23vsgroi/Battery-Charger/Battery Charger Project/Demo/README.txt

This project is an off-grid wind powered CC/CV charger for 8AH, 12V and 24V LFP battery packs.

General architecture

Wind turbine -> Generator -> Three phase rectifier -> buck converter -> battery pack
