23vsgroi/Battery-Charger/Battery Charger Project/Demo/Schematics/README.txt

For the first prototype, I will be using a gate drive evaluation board and a PCB that I am making.

The buck converter MOSFET and diode will be on the evaluation board, which can be seen on the high level schematic.
