23vsgroi/Battery-Charger/Battery Charger Project/Demo/Graphs/Charging (24V pack)/README.txt

Charging graph 1:

	On the top graph:

		Green: Battery pack terminal voltage

		Red: Battery pack VOC

	On the bottom graph:
		
		Green: Difference between pack VOC and pack terminal voltage
		Red: Battery SOC

Charging graph 2:
	
	Blue: Cell terminal voltage

	Red: Cell VOC

	Green: SOC
