23vsgroi/Battery-Charger/Battery Charger Project/Demo/Graphs/Discharging (Cell)/README.txt

Discharge graph:

	Blue: Cell VOC

	Green: Cell terminal voltage

	Red: Cell SOC
