23vsgroi/Battery-Charger/Battery Charger Project/Docs/Off-Grid Battery Charger.pptx

## Off-Grid Battery Charger

Zano Sgroi
*Currently in development: May 2026 - Present

## Project description

- 220W wind powered CC/CV charger for 12V and 24V, 8Ah LFP battery packs
- Charging rates of 1C (8A) and 0.25C (2A) based on generator frequency
- Initial prototype utilizes a gate driver evaluation board
- TI F28379D LaunchPad used for feedback control and system I/O

## High level schematic

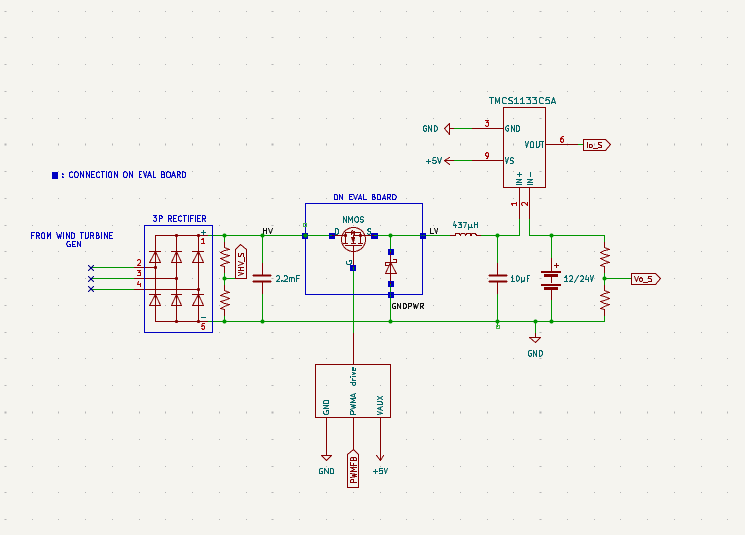
[picture p1: figure]

## PCB schematic

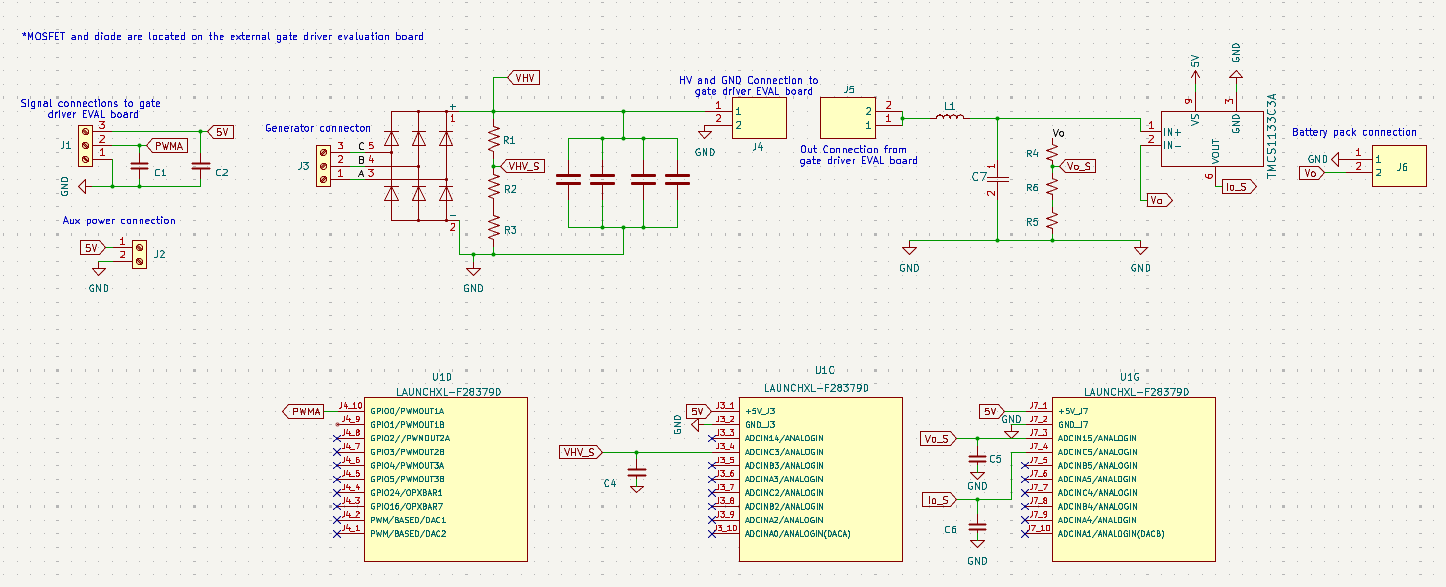
[picture p2: figure]

## PCB layout

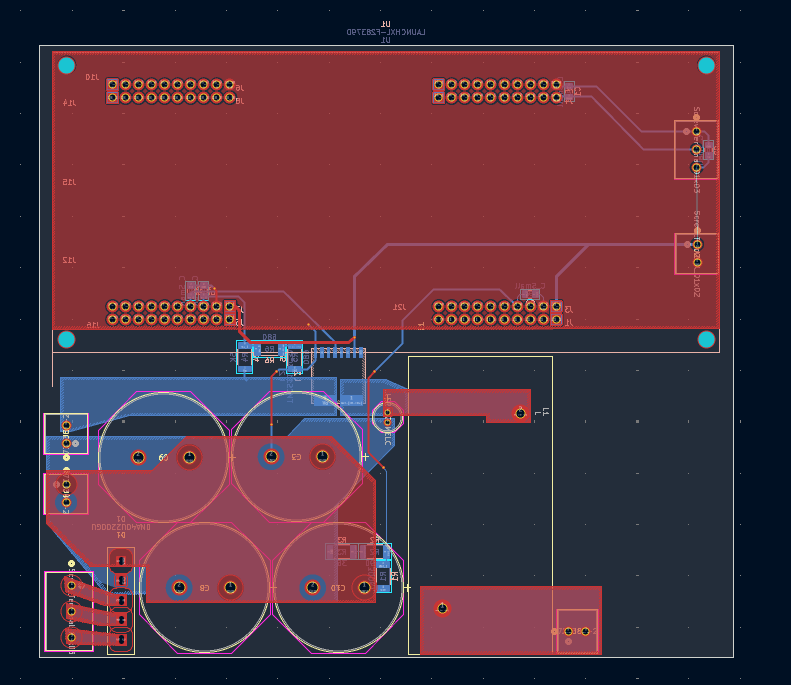
[picture p3: figure]

## Generator output data

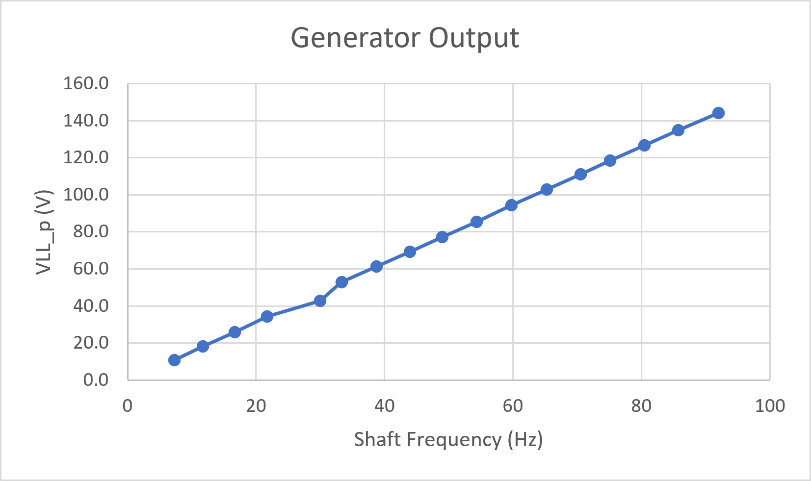
[picture p4: figure]

## PLECS system simulation

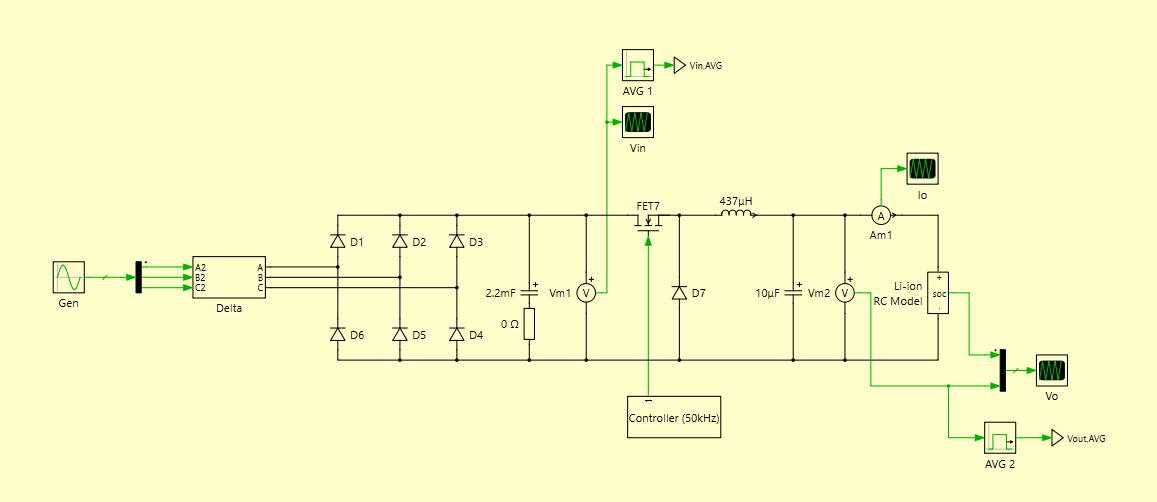
[picture p5: figure]

## Random operating point simulation

- 24V battery pack at 63% SOC
- 8A charging current
- Generator L-L peak output of 112V at 71 Hz

## Rectifier output voltage (Vm1)

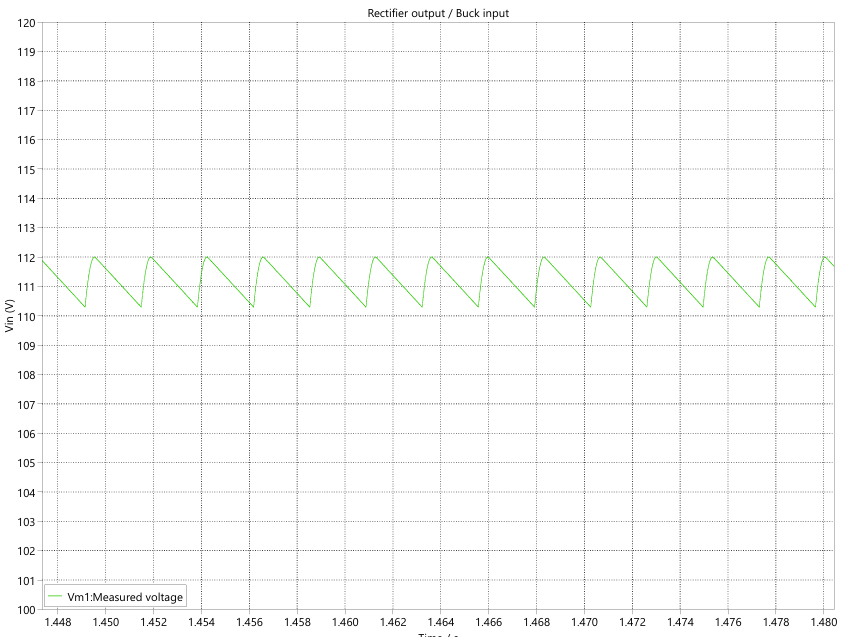
[picture p6: figure]

## Battery Voltage (Vm2)

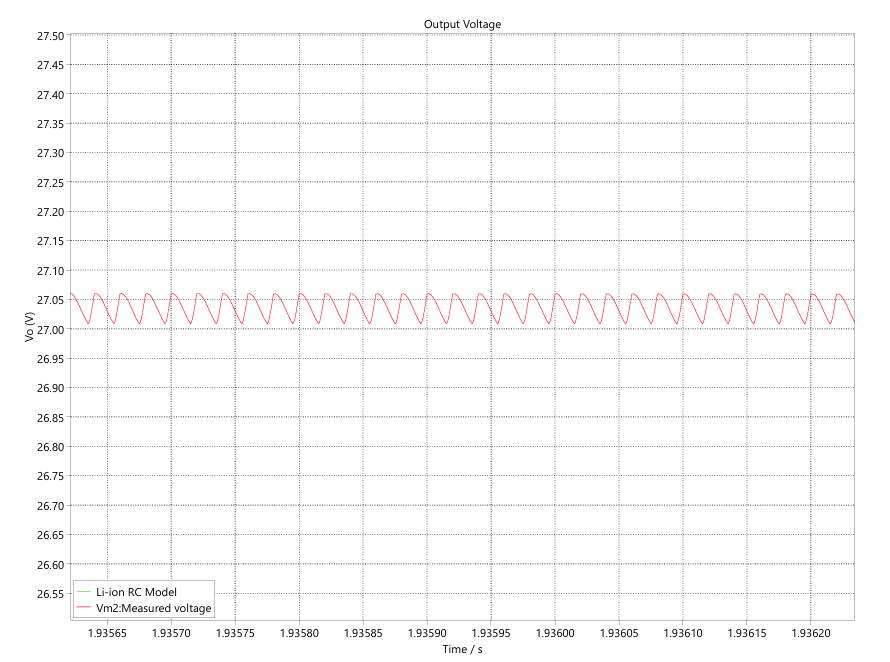
[picture p7: figure]

## Battery Current (Am1)

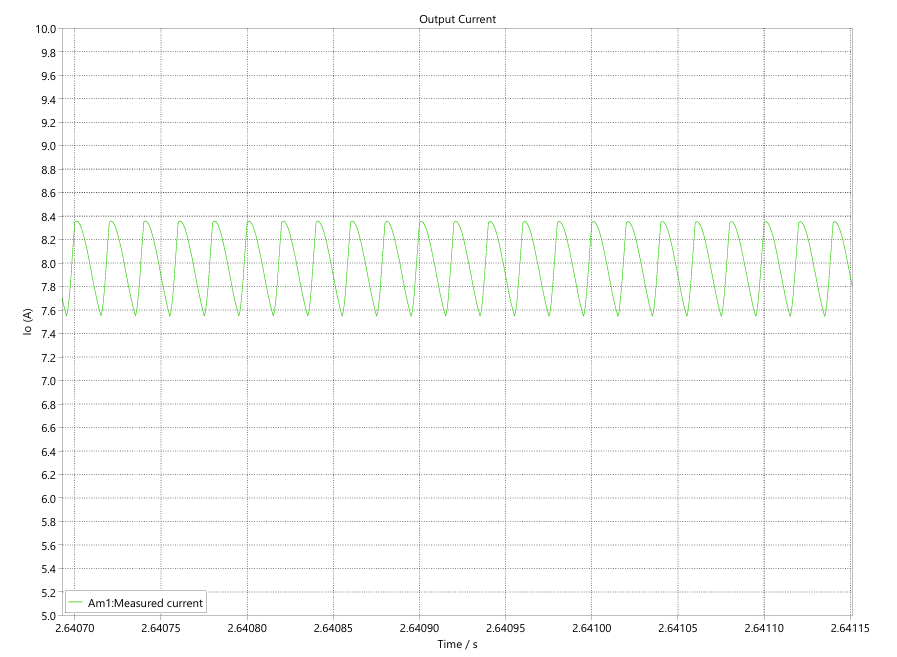
[picture p8: figure]

## LFP battery model

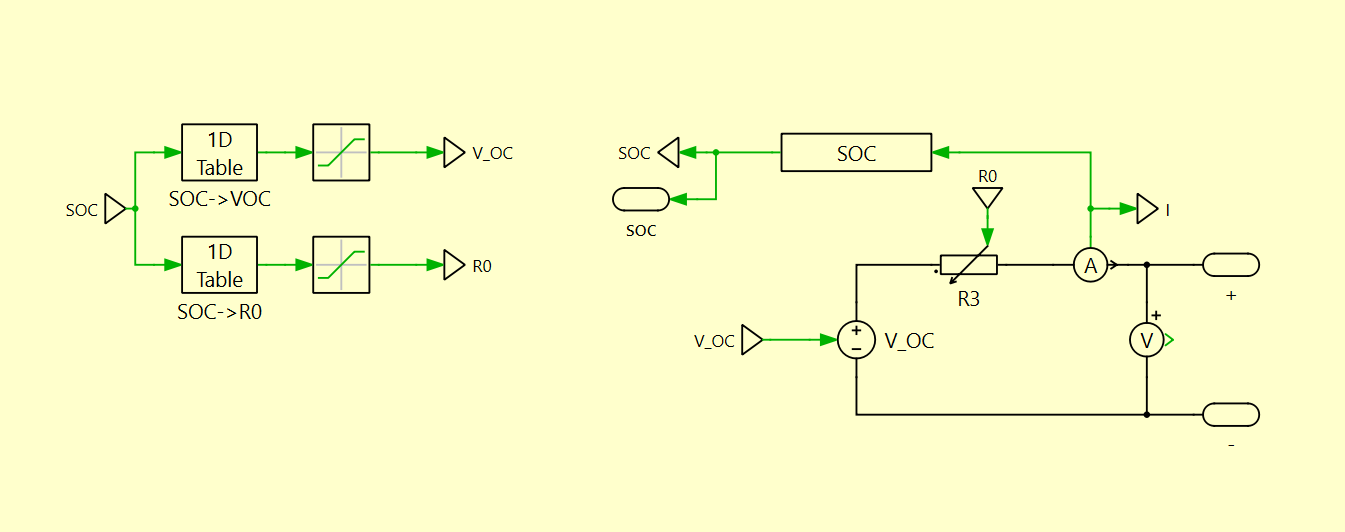
[picture p9: figure]
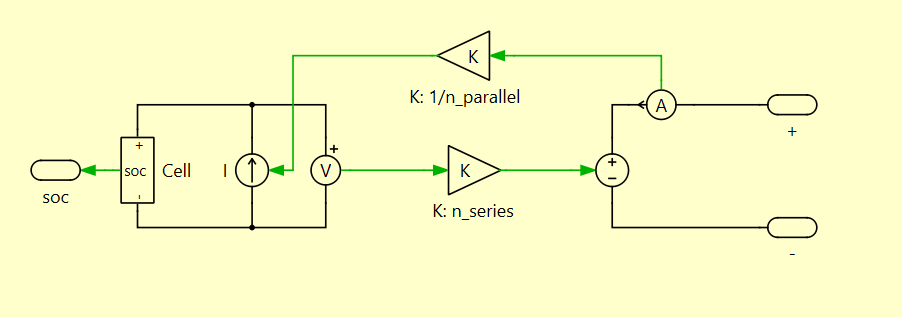
[picture p10: figure]

## Battery pack model charging simulation

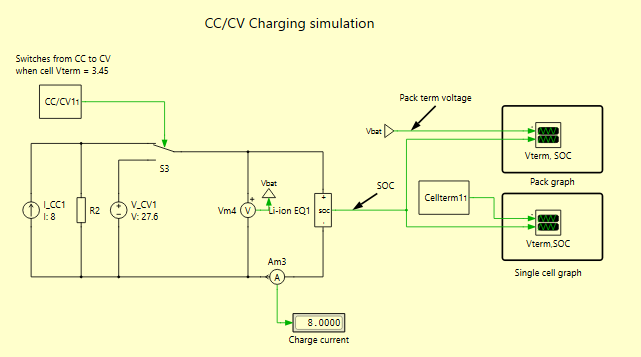
[picture p11: figure]

## Battery pack model charging graph

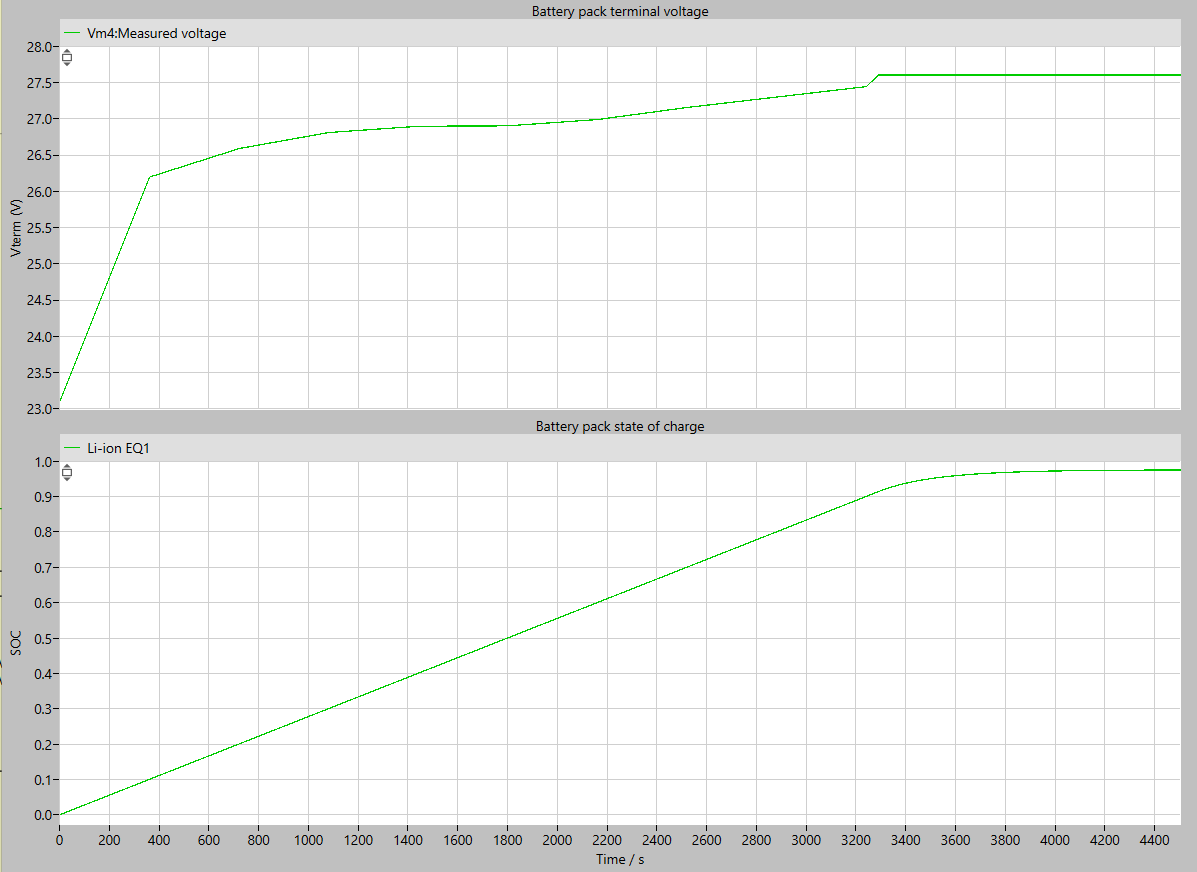
[picture p12: figure]

## Battery cell model charging graph

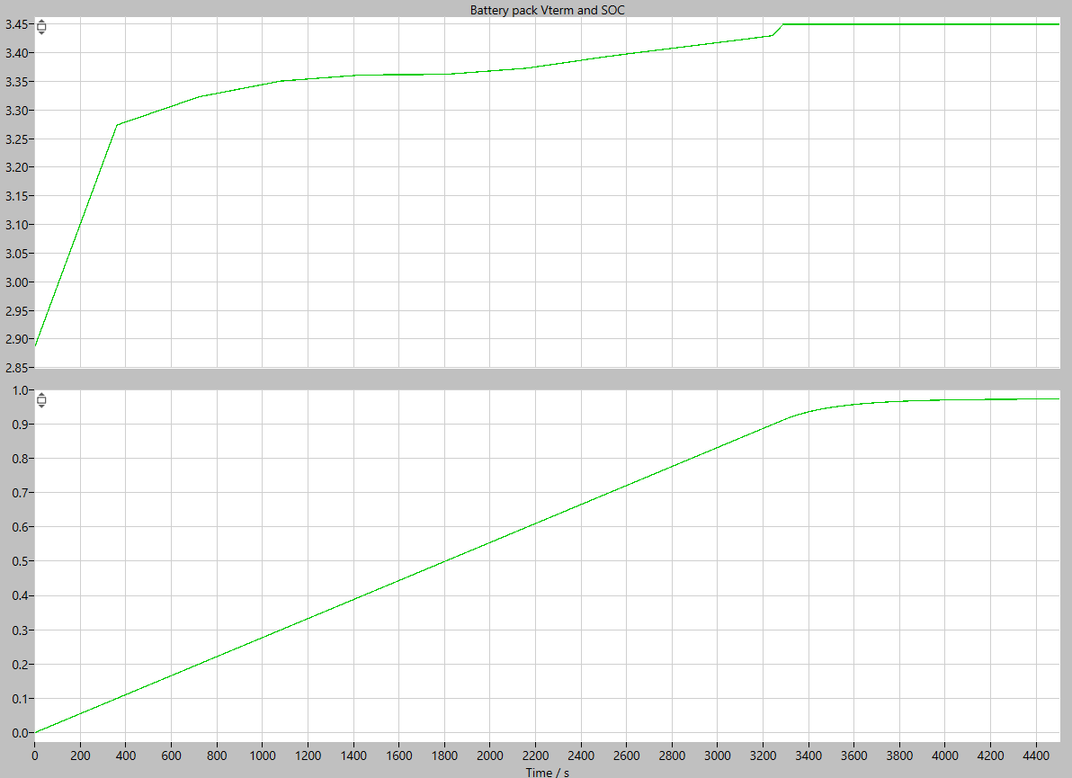
[picture p13: figure]

## Rectifier capacitor and gen freq. graphs

- MATLAB graphs show the worst-case rectifier capacitance for each VLL to keep voltage ripple below 5%
- Increasing charging currents are graphed: 1A, 2A, 4A, 8A and 12A
- 22mF point is shown on the 2A and 8A graphs
- Capacitance requirement is the same at these points due to charging current difference

## 24V pack

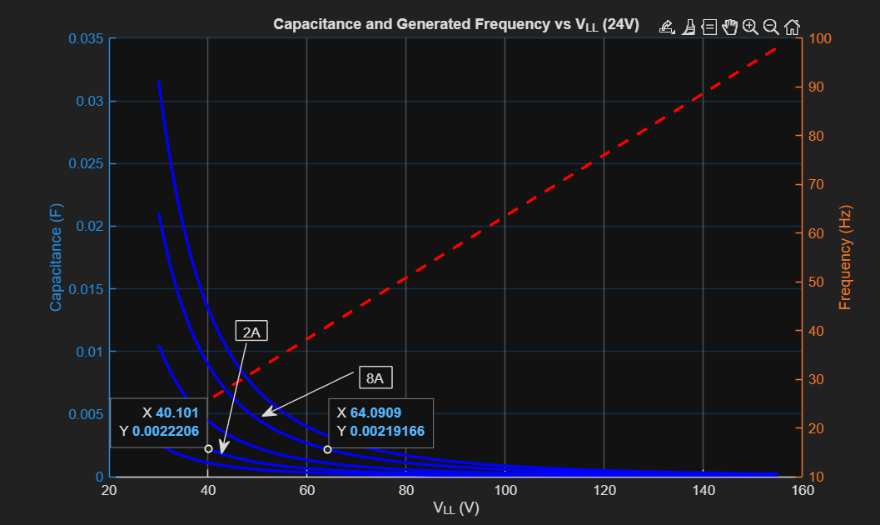
[picture p14: figure]

## 12V pack

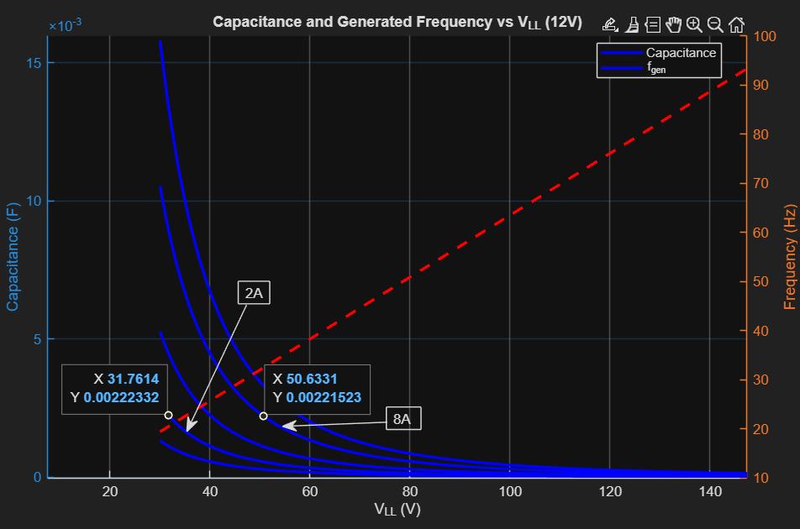
[picture p15: figure]

## Bill of materials

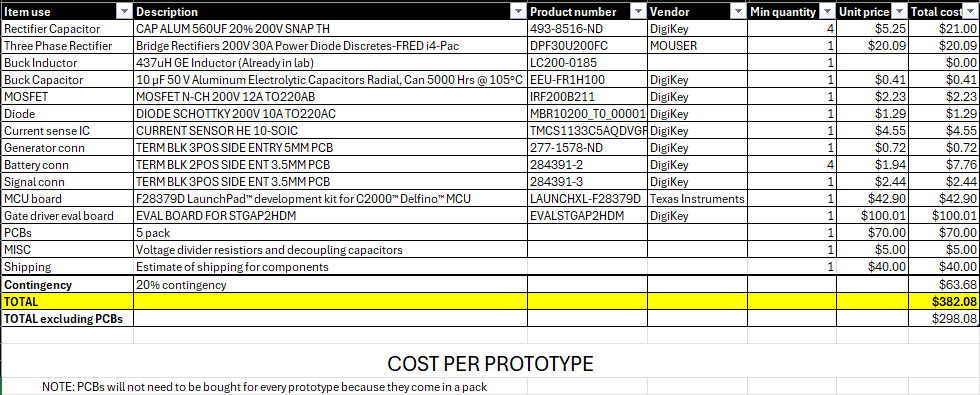
[picture p16: figure]
