23vsgroi/Battery-Charger/Battery Charger Project/Docs/Logs/BC project questions.docx

# Battery Charger Project Questions

5/12/2026

- If a buck converters input voltage changes, does the output voltage remain the same?
- ~~Does the EVALSTGAP2HD buck converter have control logic to maintain steady output voltage~~
- How does a gate driver work and what is the purpose of each terminal on the IC?
- What is the generator output voltage range
- How are CC and CV modes implemented on Buck converter?
- Will I be making the rectifiers and buck converters or using premade components?

5/13/2026

- Why can the PWM block in the feedback loop just be d=(Vref)/(Vs) to get the duty ratio?
- How would the Vc be comparison with sawtooth be implemented?
- Can the Vref in the CV feedback be used to create CC?
- How can voltage across a shunt be used in the feedback circuit to maintain constant current?
- Does resistance across a Lithium phosphate battery change as it charges
- How does battery charging work? Is it not two voltages sources in parallel?

5/21/2026

- How does a difference amplifier work?
- Will the charger use a MCU to switch from CC to CV or hardware
- How can I get 12V and 24V on my ref pin?
- When in CV mode, do you have to force current to trickle off or does it occur naturally?
- When should the MCU be used and not used?
- Will the PWM block implementation be a IC?

5/26/2026

- Is the transistor on the evaluation board the one in the actual buck converter circuit?
- How does high side gate driving work?
- What is dc to dc isolation on evaluation board?
- How does a current sensing IC work and how is the IC used?

5/28/2026

- What are open drain outputs?
- Why does the TMCS1133 IC have two VS pins?
- What is the IO voltage range on the control card?

6/2/2026

- When charging a battery pack, do you look at measure a single cell voltage or the pack voltage?
- Does the generator data sheet have the voltage in RMS, L-L, etc.?
- How many cells will be in the LFP battery pack for 12 and 24V?
- What should the minimum input to the buck converter be?
