23vsgroi/Battery-Charger/Battery Charger Project/MATLAB/Plots/V2/Charging Currents.png

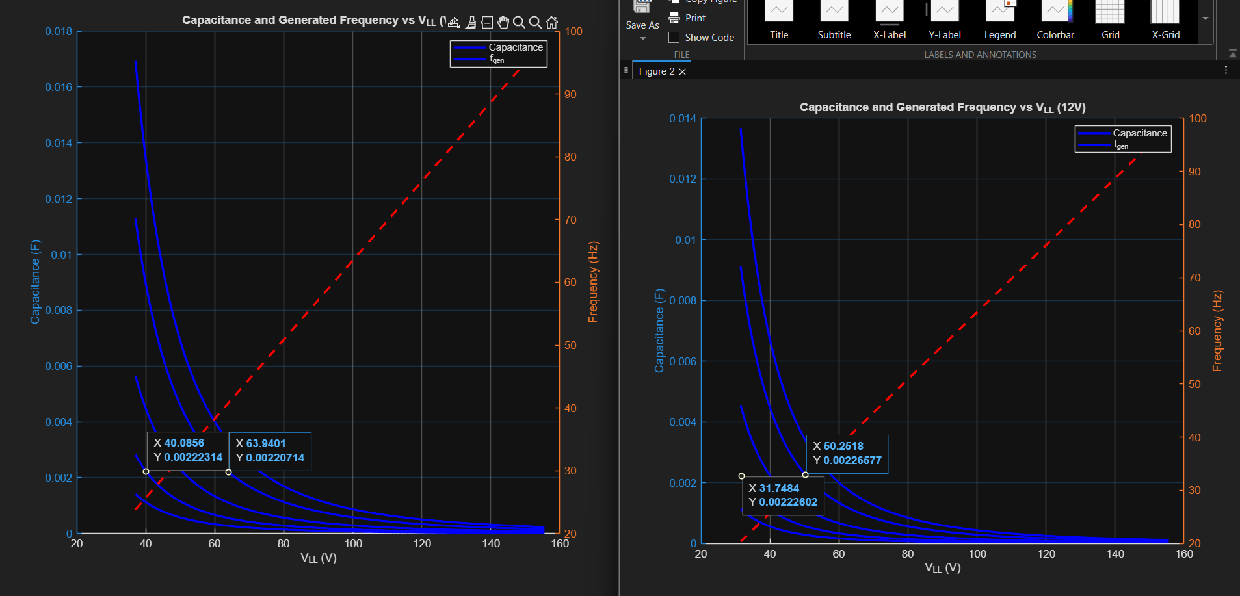
Battery Charger Project/MATLAB/Plots/V2/Charging Currents.png
