23vsgroi/Battery-Charger/Battery Charger Project/MATLAB/Plots/V2/Screenshot 2026-08-26 115330.png

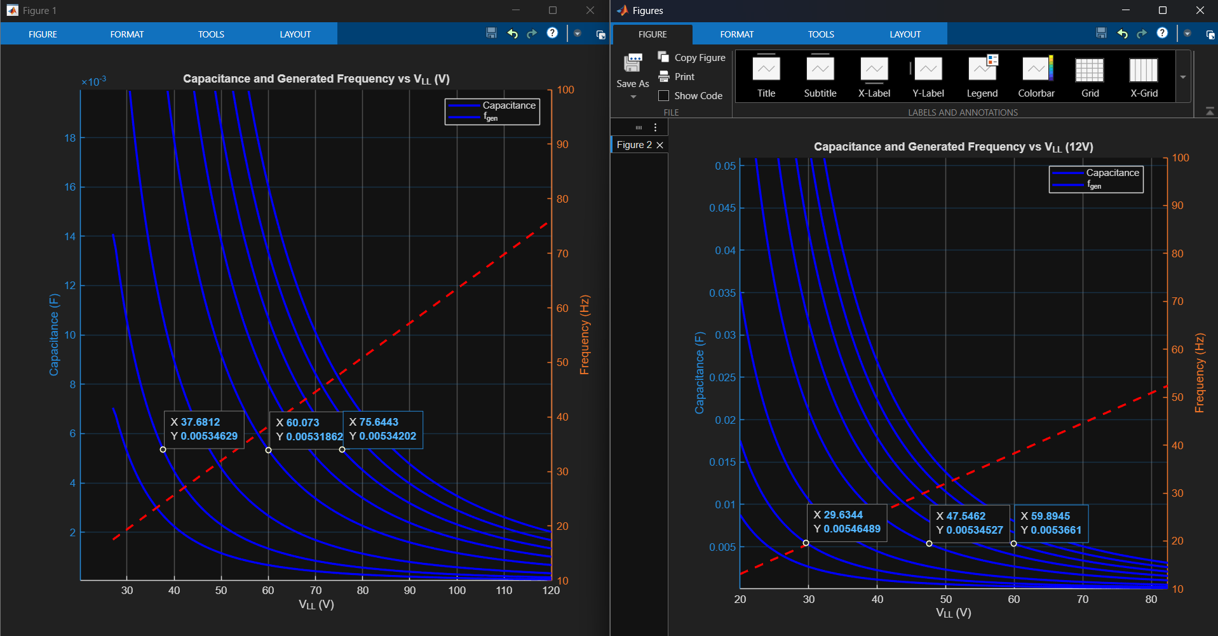
Battery Charger Project/MATLAB/Plots/V2/Screenshot 2026-08-26 115330.png
