23vsgroi/Battery-Charger/Battery Charger Project/Excel/BOM/BOM V2 UNIT.xlsx

Sheet: Minimum
Item use | Description | Product number | Vendor | Link | Min quantity | Unit price | Total cost
Rectifier Capacitor | CAP ALUM 560UF 20% 200V SNAP TH | 493-8516-ND | DigiKey | https://www.digikey.com/en/products/detail/nichicon/LGW2D561MELA30/1966872 | 4 | $5.25 | $21.00
Three Phase Rectifier | Bridge Rectifiers 200V 30A Power Diode Discretes-FRED i4-Pac | DPF30U200FC | MOUSER | https://www.mouser.com/en/ProductDetail/IXYS/DPF30U200FC?qs=rQFj71Wb1eWHztVyBgjseQ%3D%3D | 1 | $20.09 | $20.09
Buck Inductor | 437uH GE Inductor (Already in lab) | LC200-0185 |  |  | 1 |  | $0.00
Buck Capacitor | 10 µF 50 V Aluminum Electrolytic Capacitors Radial, Can 5000 Hrs @ 105°C | EEU-FR1H100 | DigiKey | https://www.digikey.com/en/products/detail/panasonic-industry/EEU-FR1H100/9921028 | 1 | $0.41 | $0.41
MOSFET | MOSFET N-CH 200V 12A TO220AB | IRF200B211-ND | DigiKey | IRF200B211 Infineon Technologies | Single FETs, MOSFETs | DigiKey (https://www.digikey.com/en/products/detail/infineon-technologies/IRF200B211/5250541) | 1 | $2.23 | $2.23
Diode | DIODE SCHOTTKY 200V 10A TO220AC | MBR10200_T0_00001 | DigiKey | https://www.digikey.com/en/products/detail/panjit-international-inc/MBR10200-T0-00001/15799461 | 1 | $1.29 | $1.29
Current sense IC | CURRENT SENSOR HE 10-SOIC | TMCS1133C5AQDVGR | DigiKey | https://www.digikey.com/en/products/detail/texas-instruments/TMCS1133C5AQDVGR/23331381 | 1 | $4.55 | $4.55
Generator conn | TERM BLK 3POS SIDE ENTRY 5MM PCB | 277-1578-ND | MOUSER | https://www.mouser.com/en/ProductDetail/Phoenix-Contact/1935174?qs=QWULklcAmSR8B7o4YouITA%3D%3D | 1 | $0.72 | $0.72
Battery conn | TERM BLK 2POS SIDE ENT 3.5MM PCB | 284391-2 | DigiKey | https://www.digikey.com/en/products/detail/te-connectivity-amp-connectors/284391-2/1827021 | 4 | $1.94 | $7.76
Signal conn | TERM BLK 3POS SIDE ENT 3.5MM PCB | 284391-3 | DigiKey | https://www.digikey.com/en/products/detail/te-connectivity-amp-connectors/284391-3/1827022 | 1 | $2.44 | $2.44
HV divider resistor | RES 5.1K OHM 1% 3/4W 2010 | RC2010FK-075K1L | DigiKey | https://www.digikey.com/en/products/detail/yageo/RC2010FK-075K1L/5921466 | 1 | $0.23 | $0.23
HV divider resistor | RES 820 OHM 1% 3/4W 2010 | RC2010FK-13820RL | DigiKey | https://www.digikey.com/en/products/detail/yageo/RC2010FK-13820RL/17016426 | 1 | $0.23 | $0.23
HV divider resistor | RES 3502 300K 1% | 3502300KFT | DigiKey | https://www.digikey.com/en/products/detail/te-connectivity-passive-product/3502300KFT/9926680 | 1 | $0.95 | $0.95
Vo divider resistor | RES 5.6K OHM 1% 1.25W 2010 | CRGP2010F5K6 | DigiKey | https://www.digikey.com/en/products/detail/te-connectivity-passive-product/CRGP2010F5K6/8577271 | 1 | $0.45 | $0.45
Vo divider resistor | RES SMD 620 OHM 1% 1W 2010 | CRCW2010620RFKEFHP | DigiKey | https://www.digikey.com/en/products/detail/vishay-dale/CRCW2010620RFKEFHP/2222172 | 1 | $0.56 | $0.56
Vo divider resistor | RES 51K OHM 1% 3/4W 2010 | RC2010FK-0751KL | DigiKey | https://www.digikey.com/en/products/detail/yageo/RC2010FK-0751KL/5921434 | 1 | $0.23 | $0.23
Decap 0.1UF | CAP CER 0.1UF 50V X7R 0805 | CC0805KRX7R9BB104 | DigiKey | https://www.digikey.com/en/products/detail/yageo/CC0805KRX7R9BB104/302874 | 1 | $0.18 | $0.18
Decap 1UF | CAP CER 1UF 50V X7R 0805 | CC0805JKX7R9BB105 | DigiKey | CC0805JKX7R9BB105 YAGEO | Ceramic Capacitors | DigiKey (https://www.digikey.com/en/products/detail/yageo/CC0805JKX7R9BB105/7164382) | 1 | $0.38 | $0.38
Decap 10UF | CAP CER 10UF 16V X5R 0805 | CC0805KRX5R7BB106 | DigiKey | https://www.digikey.com/en/products/detail/yageo/CC0805KRX5R7BB106/7164386 | 1 | $0.63 | $0.63
MCU header pins | CONN HEADER VERT 20POS 2.54MM | TSW-110-07-F-D | DigiKey | https://www.digikey.com/en/products/detail/samtec-inc/TSW-110-07-F-D/2685964 | 4 | $1.06 | $4.24
MCU board | F28379D LaunchPad™ development kit for C2000™ Delfino™ MCU | LAUNCHXL-F28379D | Texas Instruments | https://www.ti.com/tool/LAUNCHXL-F28379D (https://www.ti.com/tool/LAUNCHXL-F28379D?keyMatch=LAUNCHXL-F28379D&tisearch=universal_search&usecase=hardware) | 1 | $42.90 | $42.90
Gate driver eval board | EVAL BOARD FOR STGAP2HDM | EVALSTGAP2HDM | DigiKey | https://www.digikey.com/en/products/detail/stmicroelectronics/EVALSTGAP2HDM/ | 1 | $100.01 | $100.01
PCBs | 5 pack |  |  |  | 1 | $70.00 | $70.00
Shipping | Estimate of shipping for components |  |  |  | 1 | $40.00 | $40.00
Contingency | 20% contingency |  |  |  |  |  | $64.30
TOTAL |  |  |  |  |  |  | $385.78
TOTAL excluding PCBs |  |  |  |  |  |  | $301.78
COST PER PROTOTYPE
NOTE: PCBs will not need to be bought for every prototype because they come in a pack

Sheet: Suggested
item use | Item description | product number | vendor | link | min quantity | Quantity | unit price | Total cost
Rectifier Capacitor | CAP ALUM 560UF 20% 200V SNAP TH | 493-8516-ND | DigiKey | https://www.digikey.com/en/products/detail/nichicon/LGW2D561MELA30/1966872 | 4 | 10 | $3.61 | $36.10
Three Phase Rectifier | Bridge Rectifiers 200V 30A Power Diode Discretes-FRED i4-Pac | DPF30U200FC | MOUSER | https://www.mouser.com/en/ProductDetail/IXYS/DPF30U200FC?qs=rQFj71Wb1eWHztVyBgjseQ%3D%3D | 1 | 2 | $20.09 | $40.18
Buck Inductor | 437uH GE Inductor (Already in lab) | LC200-0185 |  |  | 1 |  |  | $0.00
Buck Capacitor | 10 µF 50 V Aluminum Electrolytic Capacitors Radial, Can 5000 Hrs @ 105°C | EEU-FR1H100 | DigiKey | https://www.digikey.com/en/products/detail/panasonic-industry/EEU-FR1H100/9921028 | 1 | 10 | $0.25 | $2.50
MOSFET | MOSFET N-CH 200V 12A TO220AB | IRF200B211 | DigiKey | IRF200B211 Infineon Technologies | Single FETs, MOSFETs | DigiKey (https://www.digikey.com/en/products/detail/infineon-technologies/IRF200B211/5250541) | 1 | 3 | $2.23 | $6.69
Diode | DIODE SCHOTTKY 200V 10A TO220AC | MBR10200_T0_00001 | DigiKey | https://www.digikey.com/en/products/detail/panjit-international-inc/MBR10200-T0-00001/15799461 | 1 | 3 | $1.29 | $3.87
Current sense IC | CURRENT SENSOR HE 10-SOIC | TMCS1133C5AQDVGR | DigiKey | https://www.digikey.com/en/products/detail/texas-instruments/TMCS1133C5AQDVGR/23331381 | 1 | 2 | $4.55 | $9.10
Generator conn | TERM BLK 3POS SIDE ENTRY 5MM PCB | 277-1578-ND | DigiKey | https://www.digikey.com/en/products/detail/phoenix-contact/1935174/568615 | 1 | 2 | $0.72 | $1.44
Battery conn | TERM BLK 2POS SIDE ENT 3.5MM PCB | 284391-2 | DigiKey | https://www.digikey.com/en/products/detail/te-connectivity-amp-connectors/284391-2/1827021 | 4 | 5 | $1.94 | $9.70
Signal conn | TERM BLK 3POS SIDE ENT 3.5MM PCB | 284391-3 | DigiKey | https://www.digikey.com/en/products/detail/te-connectivity-amp-connectors/284391-3/1827022 | 1 | 2 | $2.44 | $4.88
MCU board | F28379D LaunchPad™ development kit for C2000™ Delfino™ MCU | LAUNCHXL-F28379D | Texas Instruments | https://www.ti.com/tool/LAUNCHXL-F28379D (https://www.ti.com/tool/LAUNCHXL-F28379D?keyMatch=LAUNCHXL-F28379D&tisearch=universal_search&usecase=hardware) | 1 | 1 | $42.90 | $42.90
Gate driver eval board | EVAL BOARD FOR STGAP2HDM | EVALSTGAP2HDM | DigiKey | https://www.digikey.com/en/products/detail/stmicroelectronics/EVALSTGAP2HDM/ | 1 | 1 | $100.01 | $100.01
PCBs | 5 pack |  |  |  | 1 | 1 | $70.00 | $70.00
MISC | Voltage divider resistiors and decoupling capacitors |  |  |  | 1 | 1 | $5.00 | $5.00
Shipping | Estimate of shipping for components |  |  |  | 1 | 1 | $40.00 | $40.00
Contingency | 20% contingency |  |  |  |  |  |  | $74.47
TOTAL |  |  |  |  |  |  |  | $446.84
TOTAL excluding PCBs |  |  |  |  |  |  |  | $362.84
