23vsgroi/Battery-Charger/Battery Charger Project/Docs/Testing/P1 Test Procedure.docx

Prototype 1 Rectifier Validation

Objective: Verify three phase rectifier operation by measuring and graphing generator input voltage (VL-L ), generator frequency (fgen), and open circuit DC bus voltage (VDCOC).

Scope: PMSG, Three-Phase Rectifier, DC Bus (open circuit)

Equipment: Oscilloscope, DC motor, PMSG, PCBA

Setup:

1. Configure DC motor to spin the PMSG
2. Connect PMSG phases to screw terminal J1 in ABC order from left to right
3. Configure an oscilloscope probe to measure VL-L.
4. Configure an oscilloscope probe to measure VDCOC using screw terminal J4 for the DC bus and GND connection (left and right, respectively)

Test Procedure:

Use the DC motor to spin the PMSG at increasing intervals of 10Hz until reaching 100Hz or VL-L = 155V. At each interval, use an excel sheet to document fgen, VL-L, and VDCOC. The frequency should be determined using the VL-L oscilloscope waveform.
