23vsgroi/Battery-Charger/Battery Charger Project/Docs/Logs/BC project log.docx

# Battery Charger Project Log

5/12/2026

- Researched buck converter control loops to maintain a constant Vout for a range of Vin.
- I tried to determine if EVALSTGAP2HDM had a control loop because I thought it was a buck converter
- Researched how a gate driver worked and the pin functions
- Realized the EVALSTGAP2HDM is NOT a buck converter
- EVALSTGAP2HDM is a simplified gate driver that contains high and low transistors.
- The buck converter will need feedback to maintain a Vout
- The buck converter will facilitate the CC and CV modes

5/13/2026

- Researched the PWM block of the buck converter feedback loop
- Researched how to implement CC and CV modes on buck converter
- For CC and CV modes, the same feedback circuit is used but Vref varies for CC
- Spent the majority of my time trying to understand the CC circuit for a buck converter
- The buck converter in CC mode is effectively CV across a shunt
- I realized that the PWM uses voltage error so it can be used to control voltages other than output voltage.
- This means that the error between shunt voltage and voltage across shunt during desired current can be used to control voltage.
- I learned that an IC that modulates PWM based on error exists (TL549)

5/21/2026

- Making a rough draft for the CC and CV feedback circuits
- Working on making a circuit to switch from CC to CV
- Researched if MOSFETs would work to pass the error to PWM block
- Made a rough schematic of the entire system

5/26/2026

- Met with Mcintyre and wrote down notes
- Researched the evaluation board and how it works
- Researched high side MOSFET gate driving, bootstrap circuit, and electrical isolation
- The Evaluation board uses Isolated dc to dc system that always puts the gate higher voltage than the source.
- Learned that a current sensing IC works by using a diff amp across a sense resistor

5/28/2026

- Downloaded plex
- Learning about Hall Effect current sensor
- More research how we need to use the Eval board
- Researching the control card to determine max input voltage
- The ADC conversion range on the MCU is 0 to 3.3V
- Looking for a potential rectifier

6/4/2026

- Trying to figure out what the maximum duty cycle of the buck converter would be
- Confused what is needed to determine the buck inputs
- Making Kicad schematic for the system
- The current sensing IC has a Vout 0f 100mV to (Vs – 100mV)

6/9/2026

- made an excel sheet for calculations over the weekend
- I had an oversight when choosing the minimum buck input voltage. I made it so the minimum input was Vo,min/D, but this means it would not be able to charge the battery at min input when the battery voltage increased. This also somehow caused power from the generator to be constant throughout the charge. I updated it so the minimum input is Vo,max/D, so it can charge the battery on minimum input no matter where the charge is. This also fixed the equal power problem.

6/23/2026

- Working on a Plecs simulation that includes the rectifier and the buck converter
- Delta is used for L-L with no neutral
- I had bad current ripple because I wasn’t measuring the inductor current correctly
- I need to figure out if the capacitor current is accurate

6/31/2026

- I was having an issue where every part of the operating point was correct except voltage ripple, which was much lower than anticipated. It was also a saw tooth shape instead of smooth.
- I found out that this is because the sampling rate was to low to create a good plot
- After I fixed the sampling the voltage ripple was just as I anticipated
- I have been doing calculations with an excel sheet then inputting them into plecs
- I realized that the rectifier filter capacitor is based off the frequency of the input, but the frequency will change based on the wind speed
- The rectifier filter capacitor will need to be designed with the worst case in mind
- I am going to simulate at various key operating points, then I will try to add programing to the simulation

7/7/2026

- I am working on an MATLAB program to help me do worst case analysis
- It will show various parameter at all possible operating points
