23vsgroi/Battery-Charger/Battery Charger Project/MATLAB/Plots/Rec ripple/12V 8A.pdf

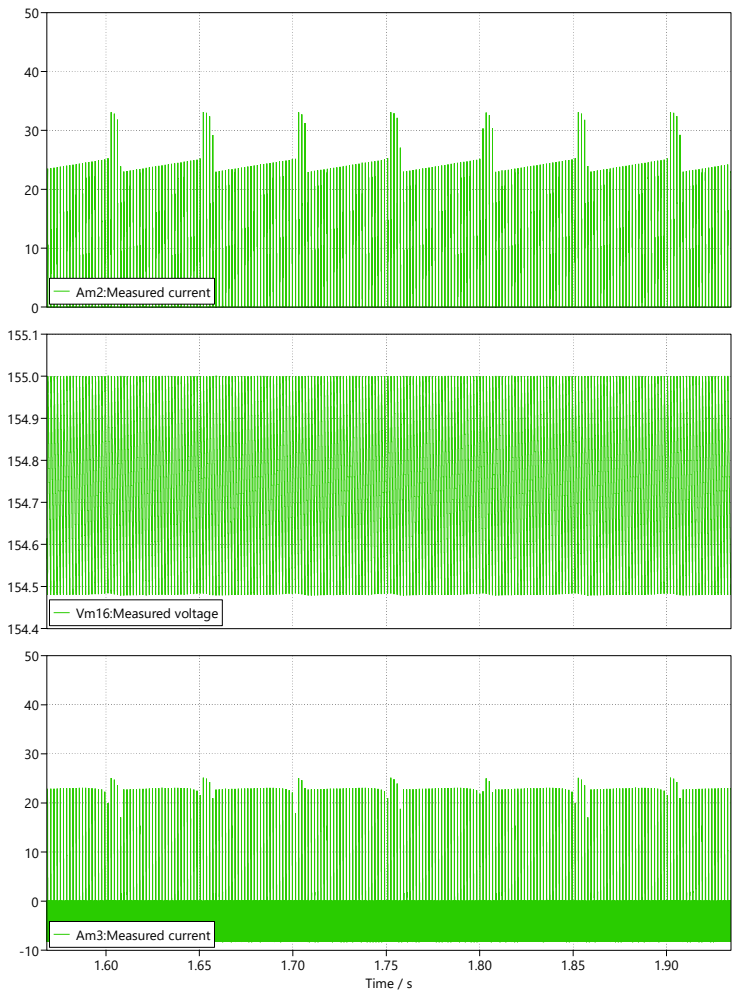
[picture p19: page 1]
Time / s; Am2:Measured current; Vm16:Measured voltage; Am3:Measured current
