23vsgroi/Battery-Charger/Battery Charger Project/MATLAB/Plots/Rec ripple/24V 8A.pdf

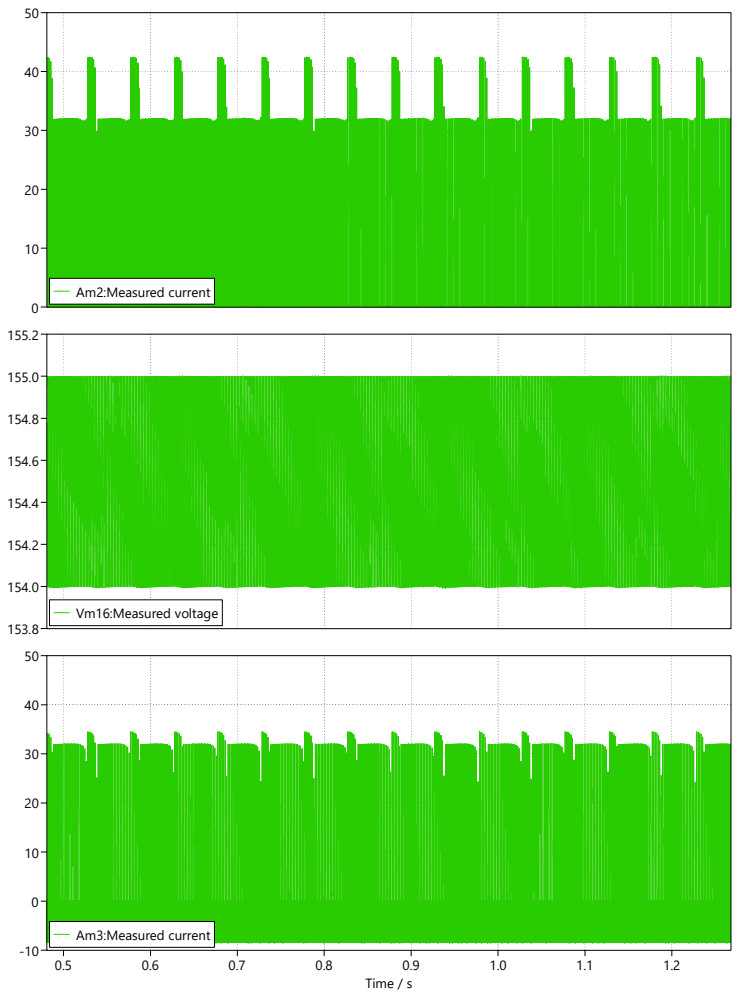
[picture p20: page 1]
Time / s; Am2:Measured current; Vm16:Measured voltage; Am3:Measured current
