23vsgroi/Battery-Charger/Battery Charger Project/Demo/Graphs/Charging (24V pack)/Charging graph 1.pdf

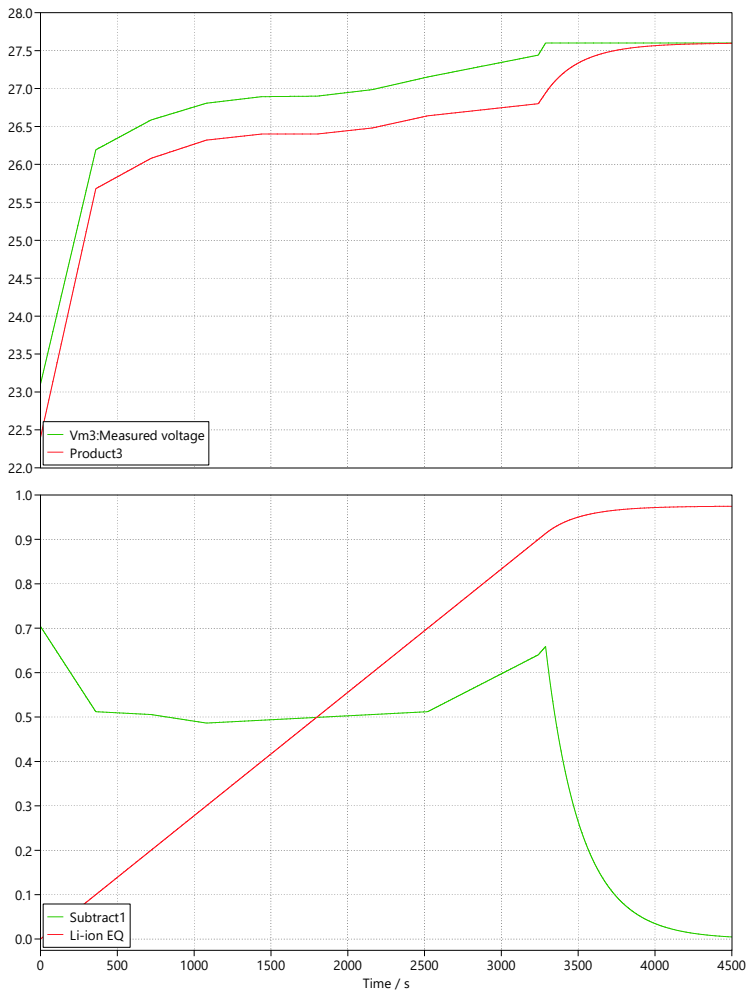
[picture p21: page 1]
Time / s; Vm3:Measured voltage Product3

Subtract1
Li-ion EQ
