23vsgroi/Battery-Charger/Battery Charger Project/Demo/Graphs/Discharging (Cell)/Discharge graph.pdf

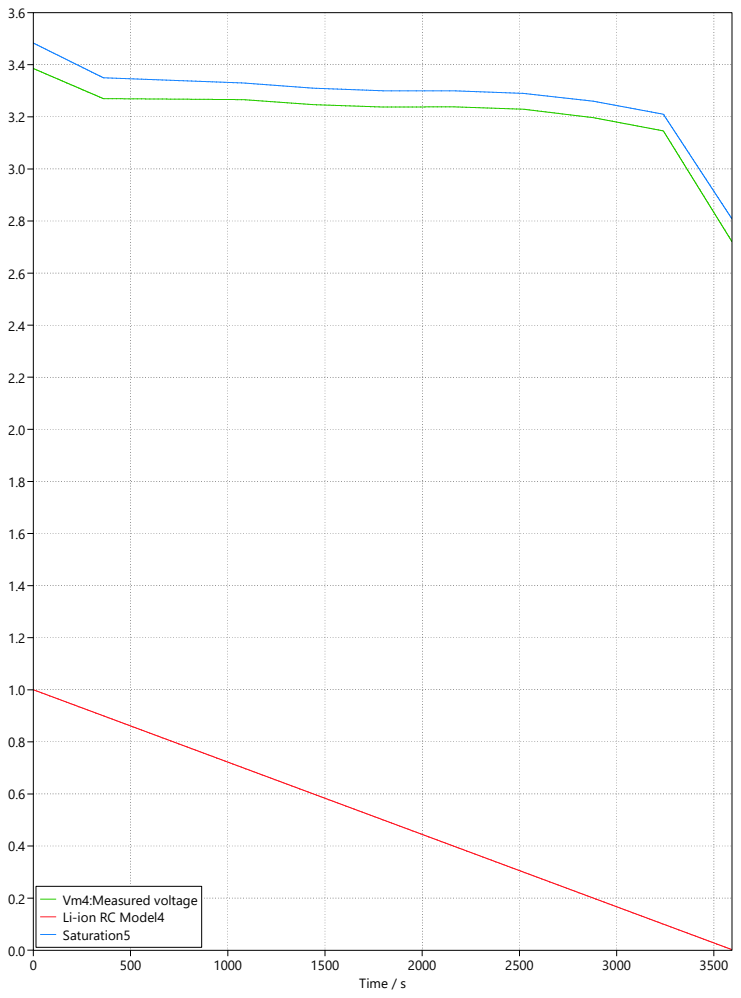
[picture p22: page 1]
Time / s

Vm4:Measured voltage
Li-ion RC Model4
Saturation5
