23vsgroi/Battery-Charger/Battery Charger Project/Plecs/Graph/3C/CC/Charge 1.pdf

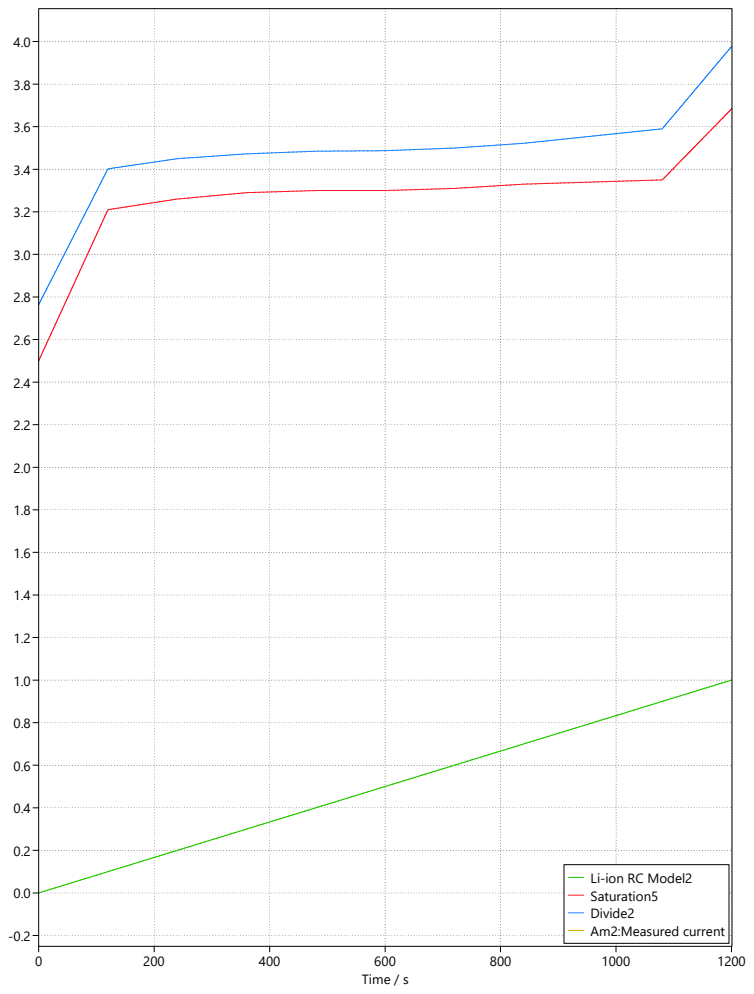
[picture p24: page 1]
Time / s; Li-ion RC Model2 Saturation5 Divide2 Am2:Measured current
