23vsgroi/Battery-Charger/Battery Charger Project/Plecs/Graph/3C/CC/Charge 2.pdf

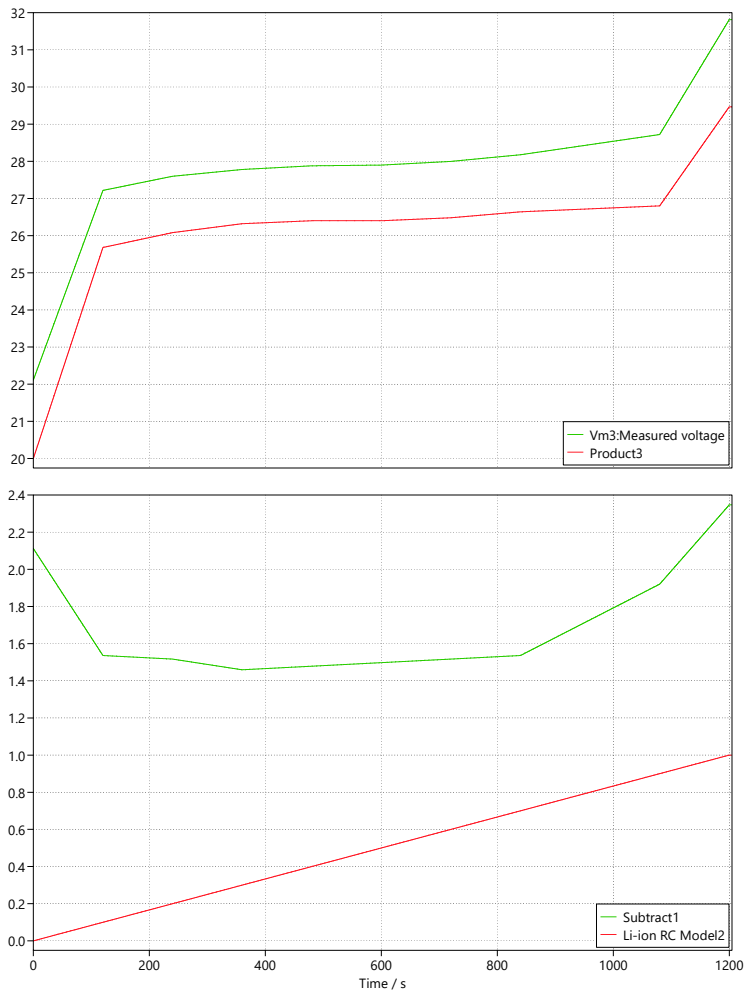
[picture p25: page 1]
Time / s; Vm3:Measured voltage Product3

Subtract1
Li-ion RC Model2
