23vsgroi/Battery-Charger/Battery Charger Project/Plecs/Graph/3C/CC/Discharge.pdf

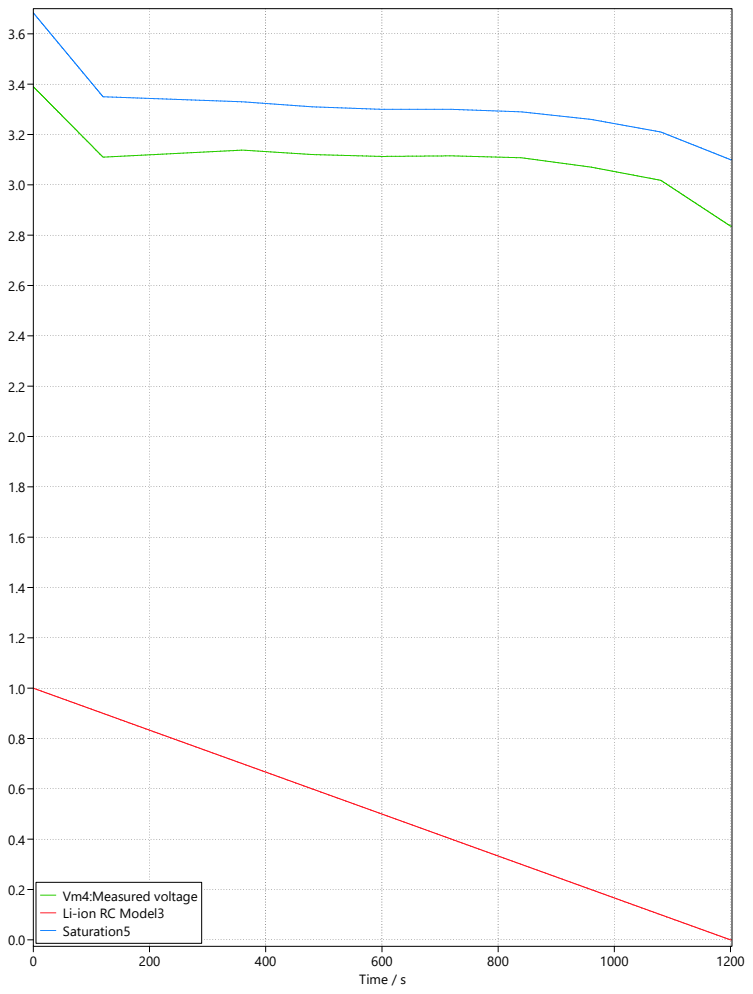
[picture p26: page 1]
Time / s

Vm4:Measured voltage
Li-ion RC Model3
Saturation5
