23vsgroi/Battery-Charger/Battery Charger Project/Plecs/Graph/1C/CC-CV/Charging/Charge 1.pdf

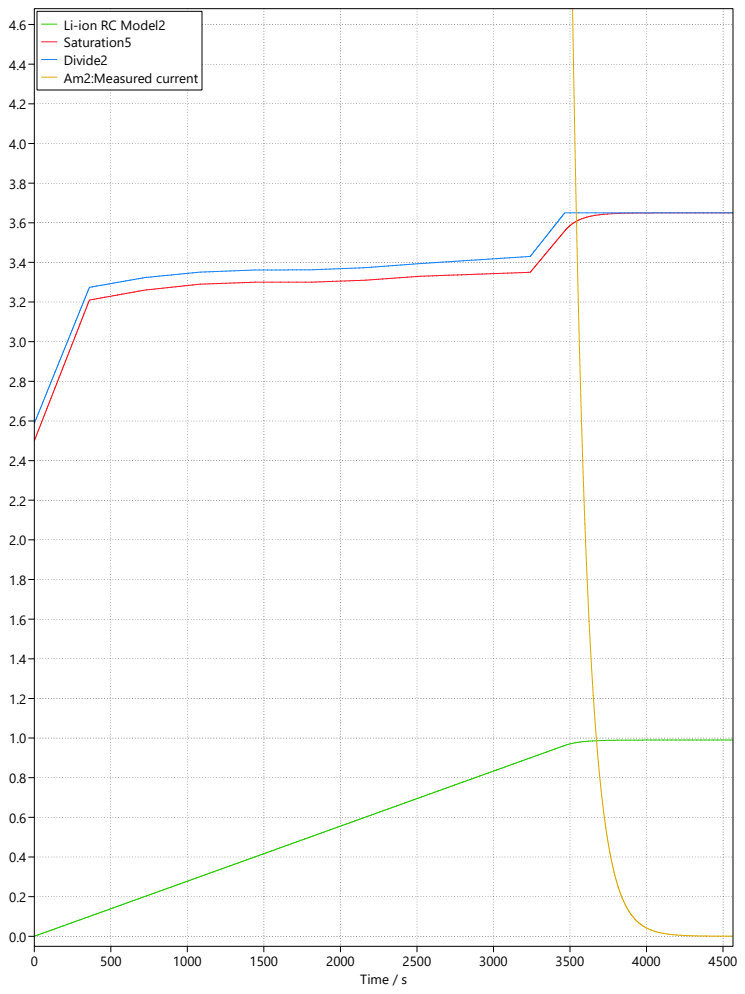
[picture p27: page 1]
Time / s; Saturation5 Divide2 Am2:Measured current

4.6 Li-ion RC Model2
