23vsgroi/Battery-Charger/Battery Charger Project/Plecs/Graph/1C/CC-CV/Charging/Charge 2.pdf

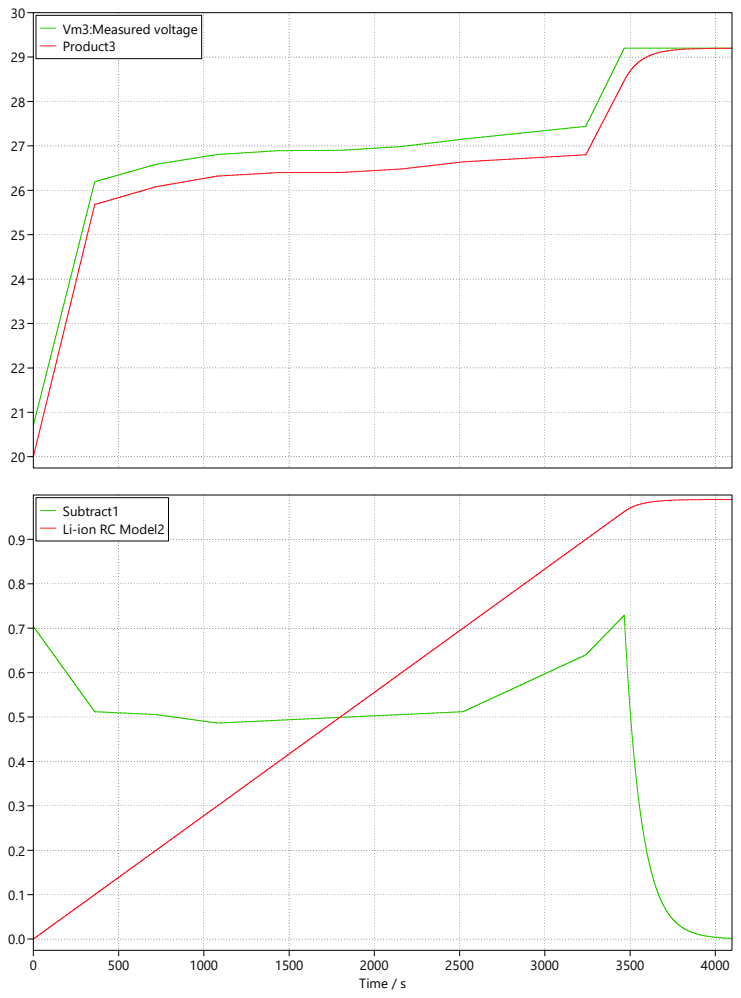
[picture p28: page 1]
Time / s; Vm3:Measured voltage Product3

Subtract1
Li-ion RC Model2
