23vsgroi/Battery-Charger/Battery Charger Project/Plecs/Graph/1C/CC-CV/Discharge/Discharge.pdf

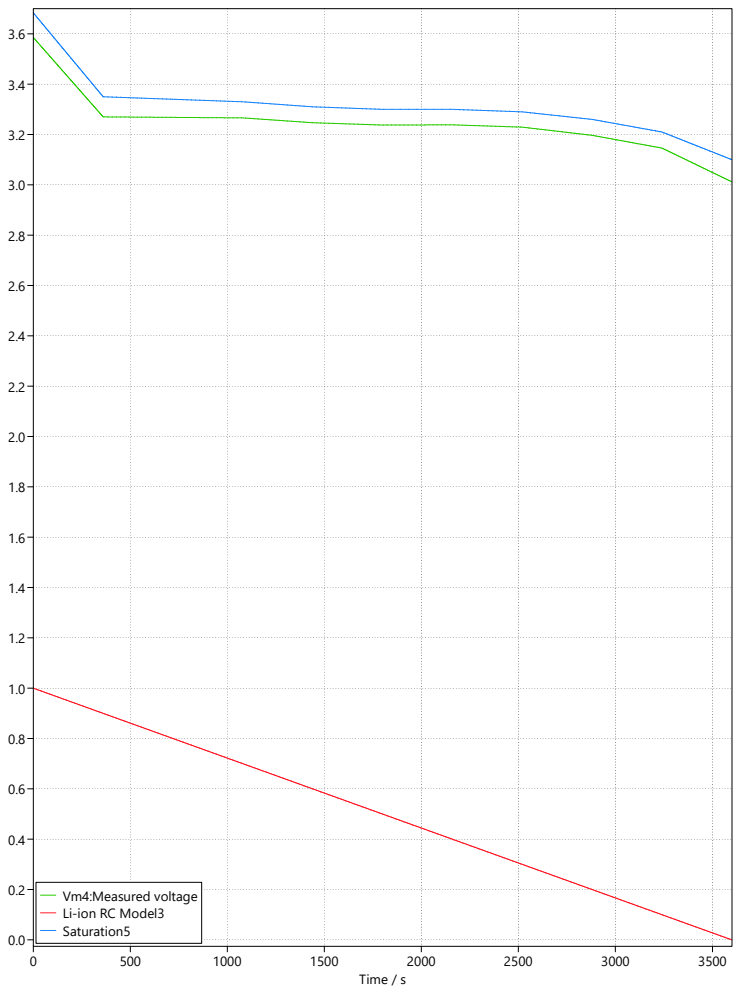
[picture p29: page 1]
Time / s

Vm4:Measured voltage
Li-ion RC Model3
Saturation5
