23vsgroi/Battery-Charger/Battery Charger Project/Docs/Charger schematic.pdf

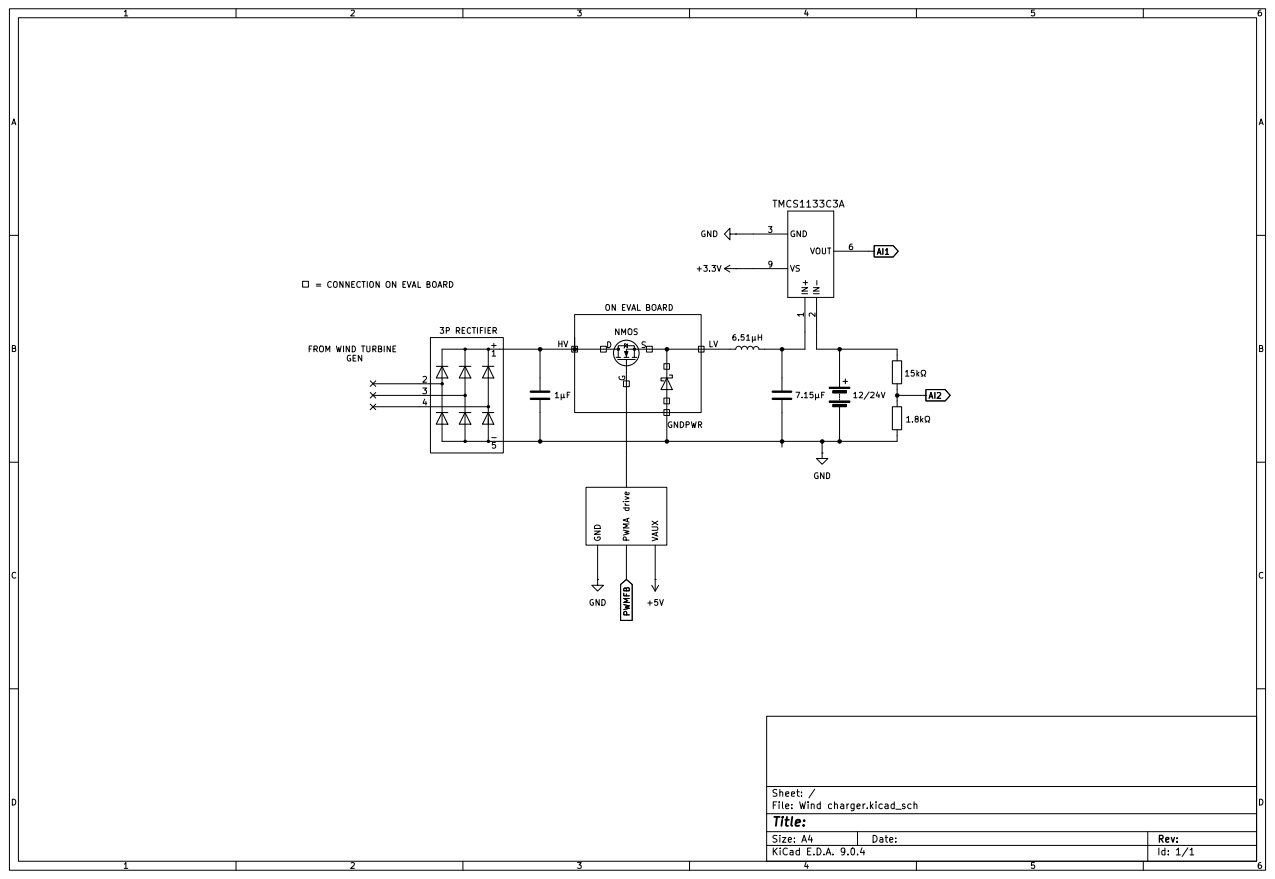
[picture p30: page 1]
