23vsgroi/Battery-Charger/Battery Charger Project/Demo/Schematics/High level schematic.pdf

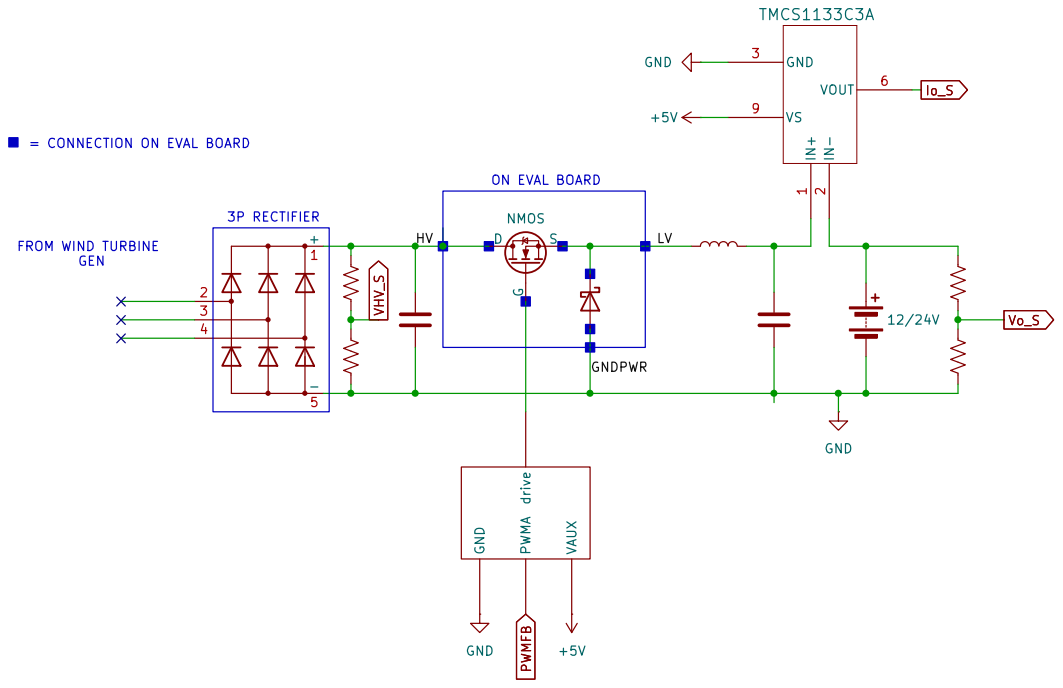
[picture p31: page 1]
