23vsgroi/Battery-Charger/Battery Charger Project/Demo/Schematics/Kicad schematic.pdf

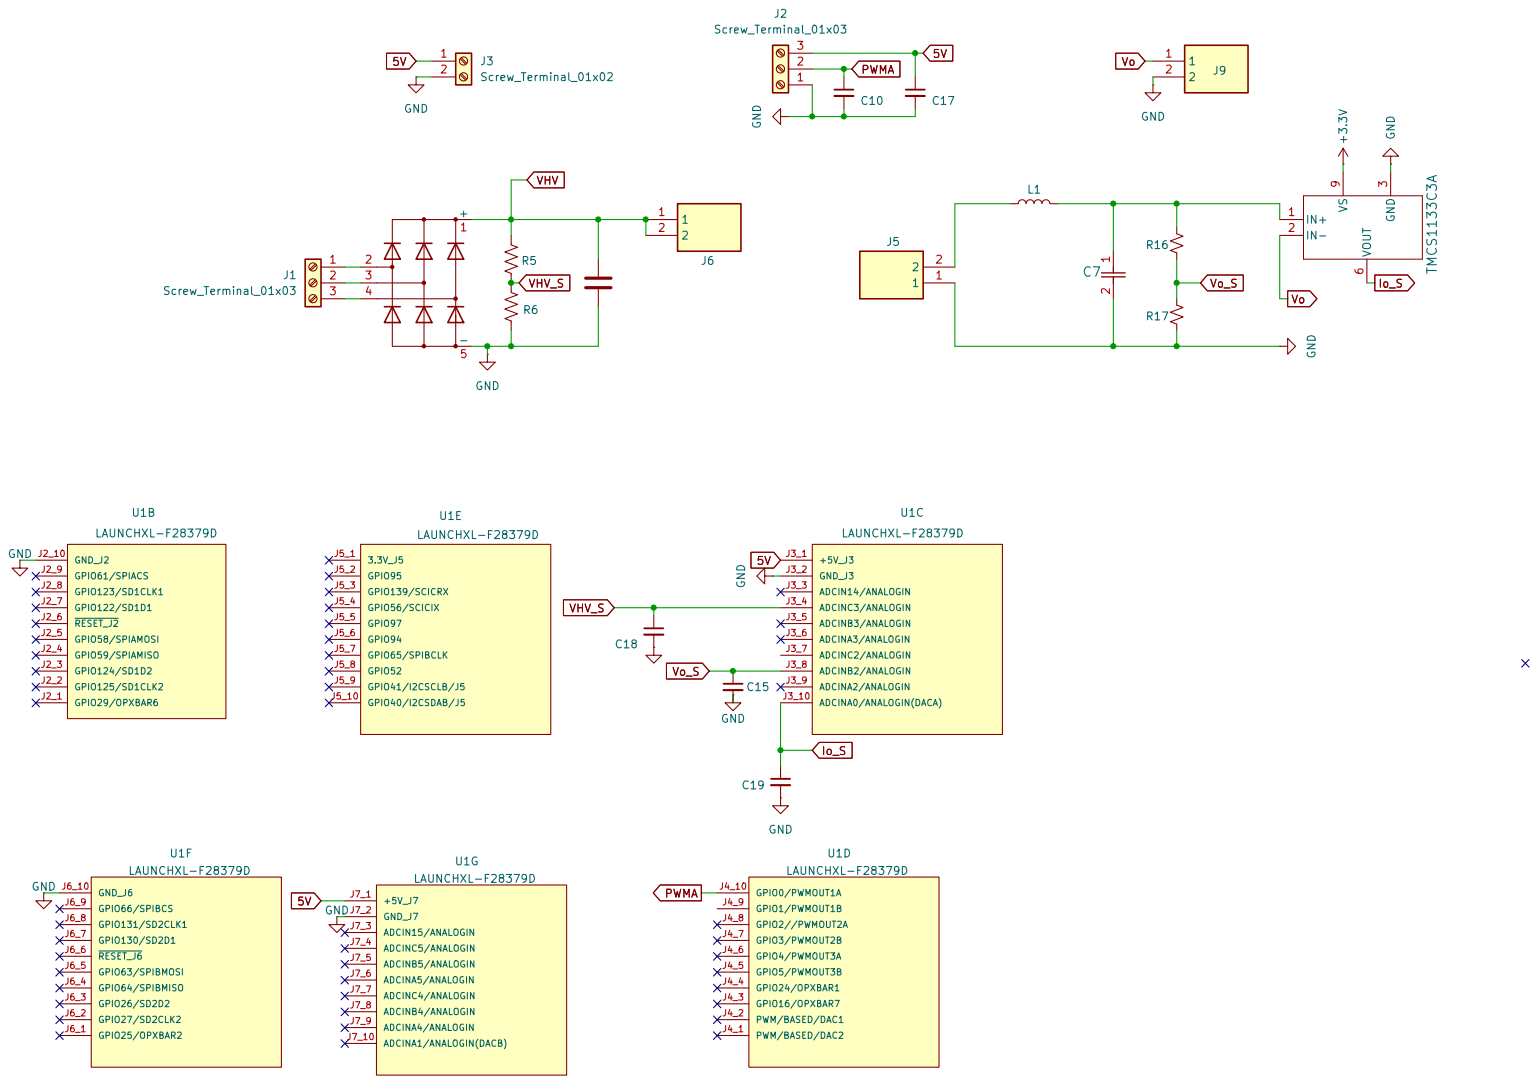
[picture p32: page 1]
