23vsgroi/Battery-Charger/Battery Charger Project/Demo/Graphs/Charging (24V pack)/Charging graph 2.pdf

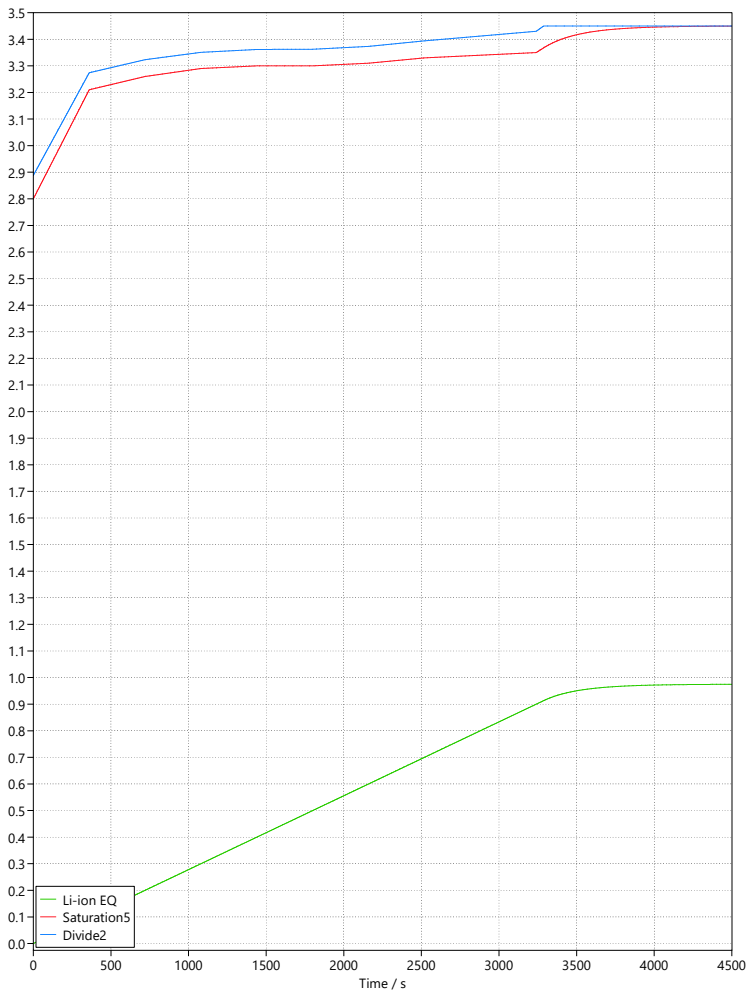
[picture p33: page 1]
Time / s; Li-ion EQ Saturation5 Divide2
