23vsgroi/Battery-Charger/Battery Charger Project/Plecs/Graph/3C/CC-CV/Charge 1.pdf

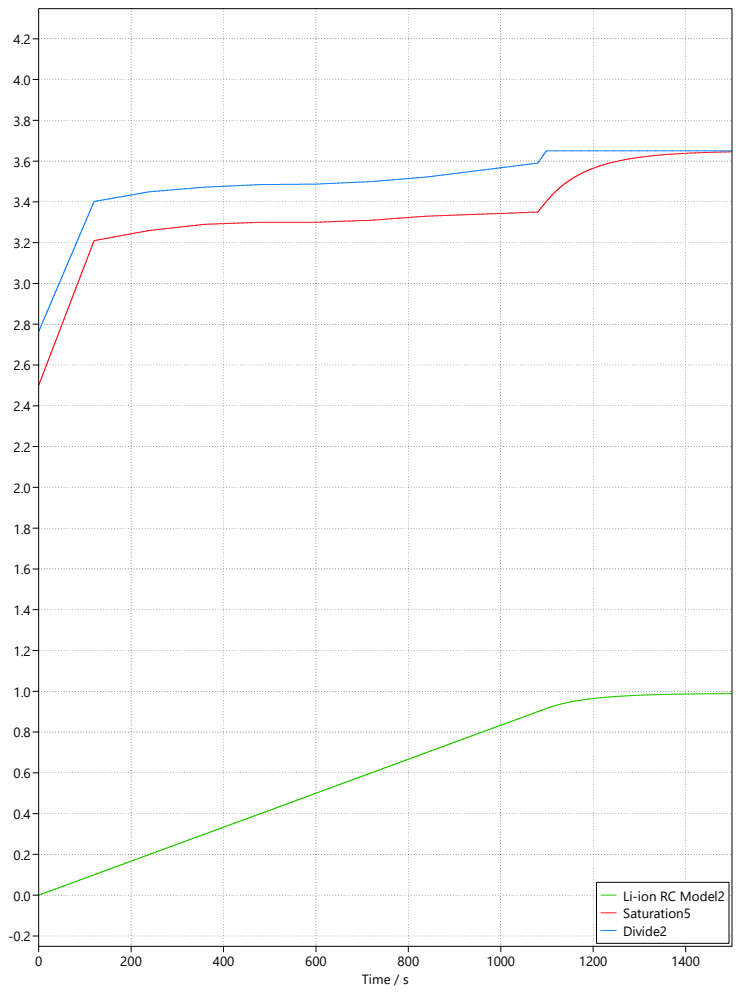
[picture p34: page 1]
Time / s; Li-ion RC Model2 Saturation5 Divide2
