23vsgroi/Battery-Charger/Battery Charger Project/KiCad/Build/Build.kicad_pcb

## KiCad design Battery Charger Project/KiCad/Build/Build.kicad_pcb (2026-10-22)

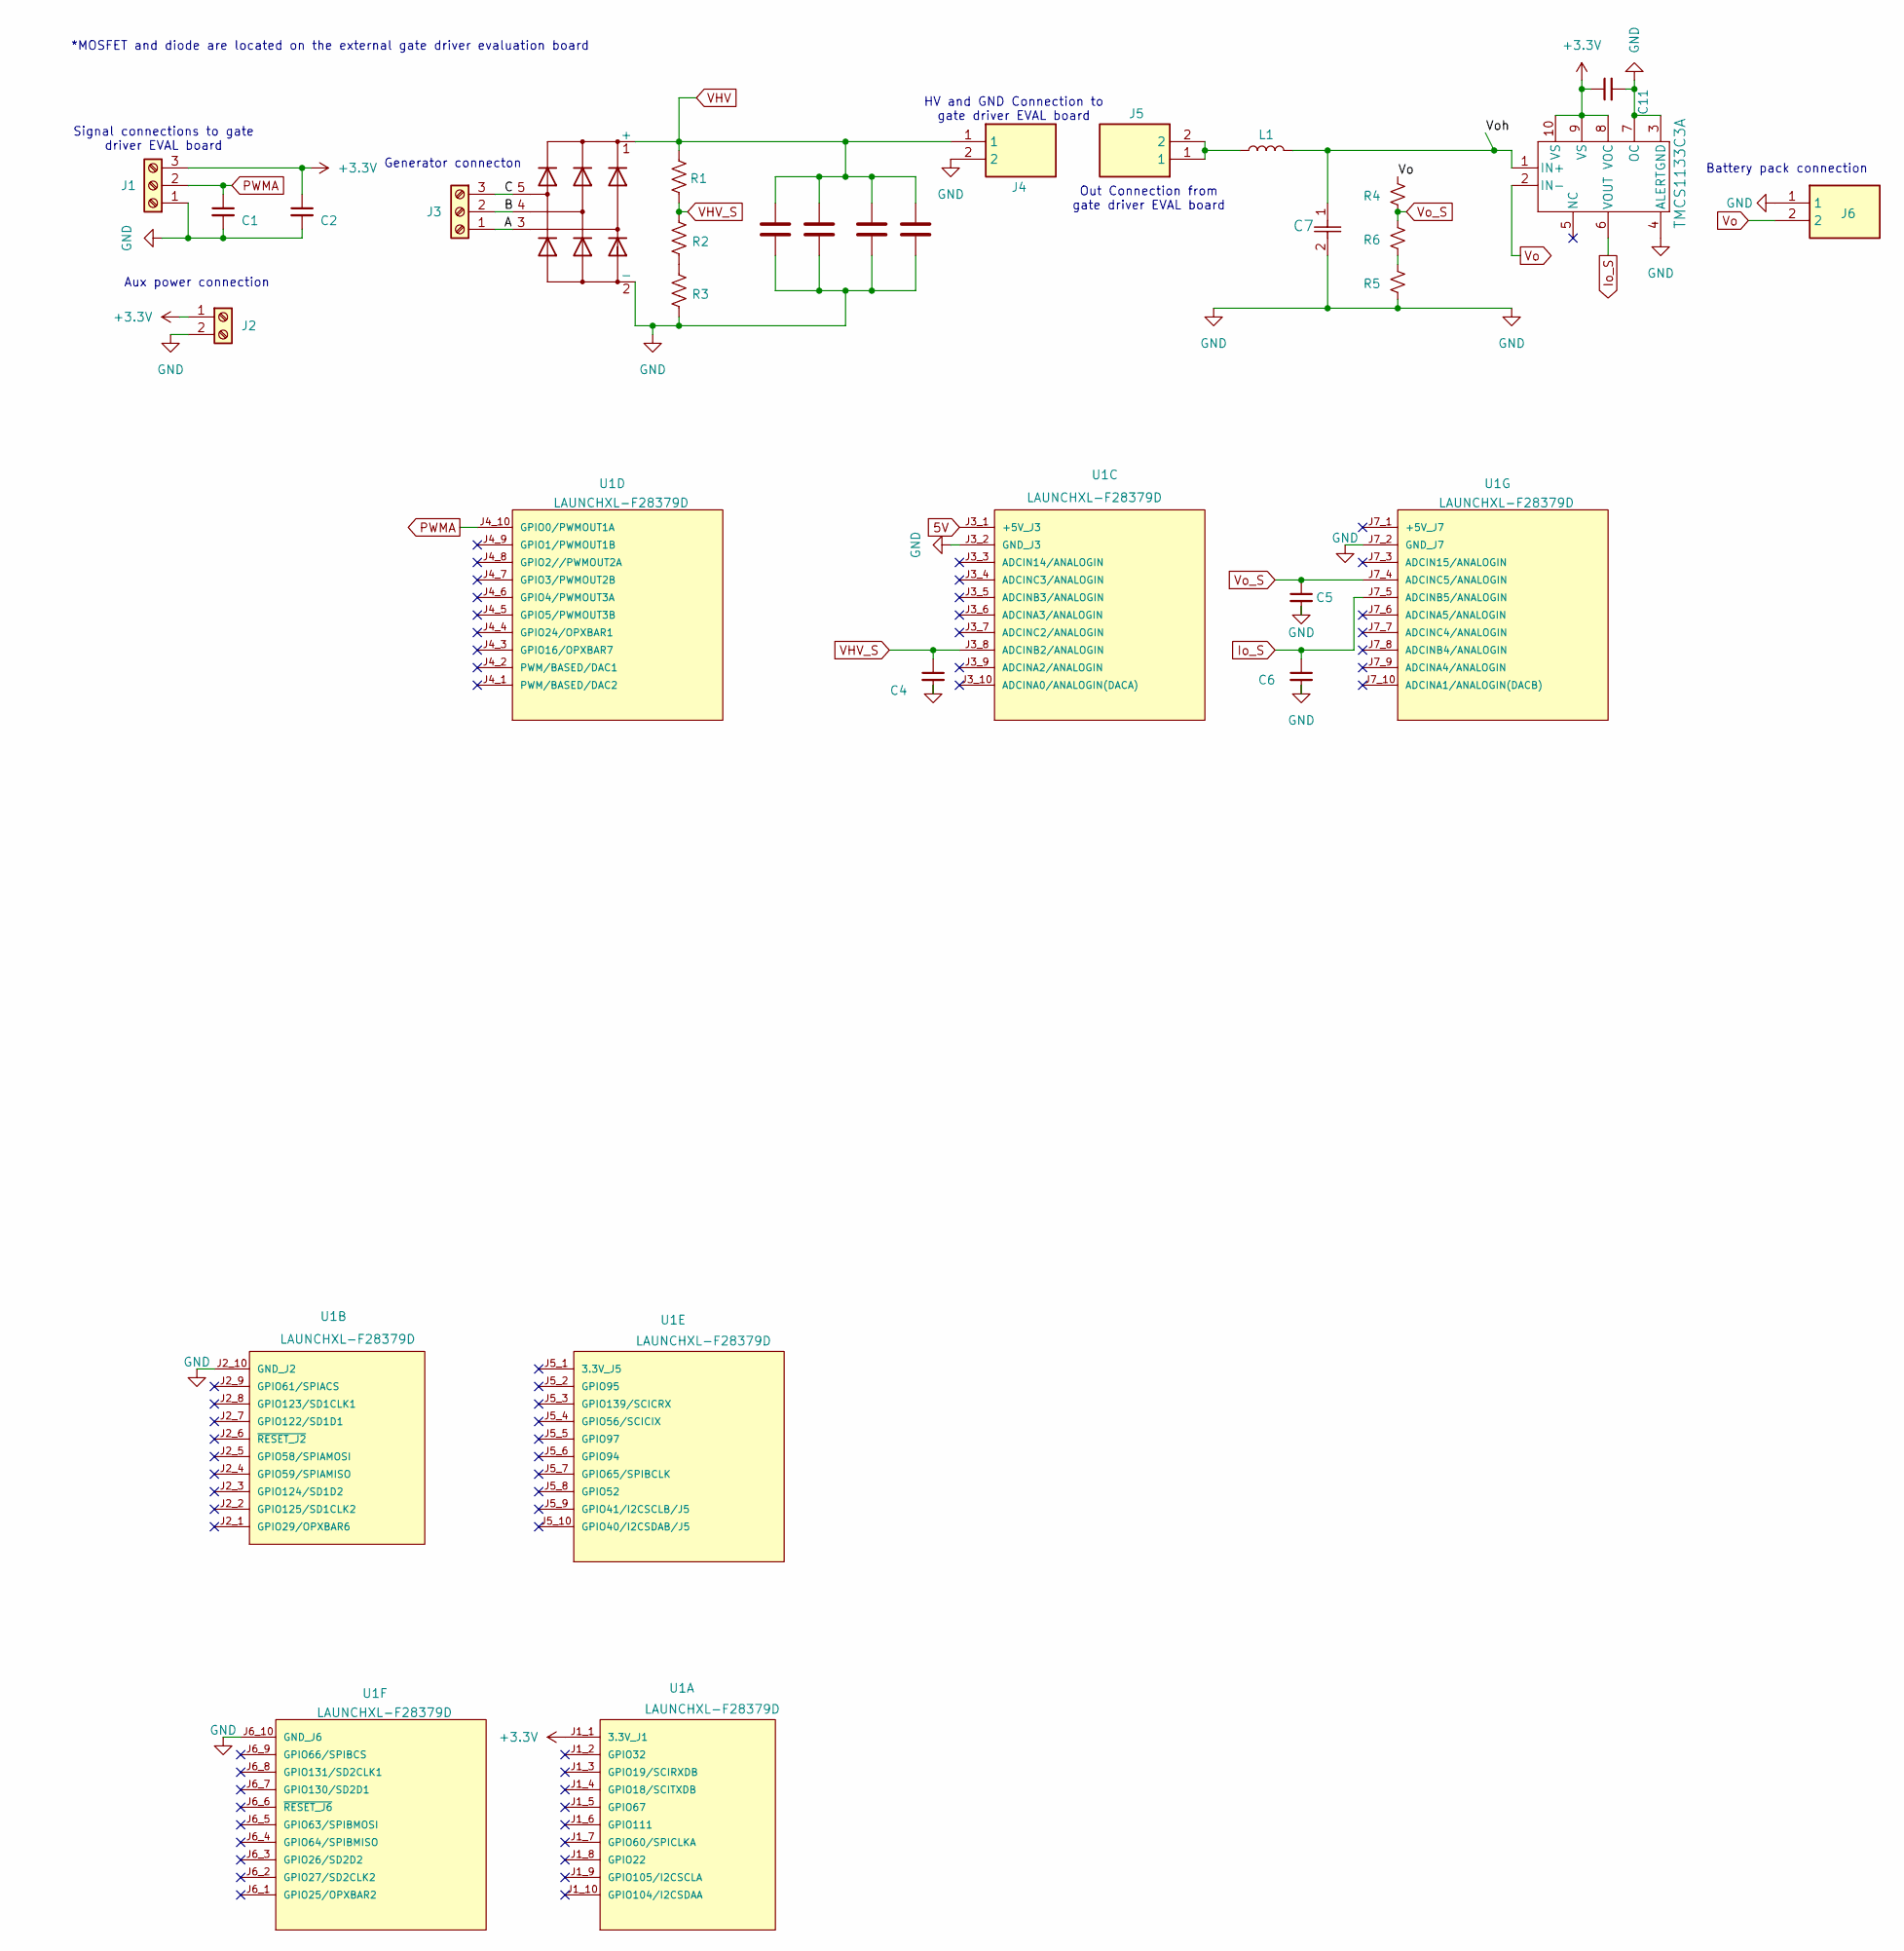
[picture p35: schematic Build.kicad_sch]

Parts:
C1, C2, C4, C5, C6, C11: C_Small; C_0805_2012Metric_Pad1.18x1.45mm_HandSolder
C3, C8, C9, C10: CAP_A30_NCH
C7: LLS2V821MELC; CAP_PAN_5X11_PAN
D1: DNA40U2200GU; DPF30U200FC
J1: Screw_Terminal_01x03; CONN3_284391-3_TEC
J2: Screw_Terminal_01x02; CONN2_284391-2_TEC
J3: Screw_Terminal_01x03; CONN_1935174_PXC
J4, J5, J6: 726386-2; CONN2_284391-2_TEC; Mouser Part Number 571-726386-2
L1: L; LC200-0185
R1: 300K; R_2010_5025Metric
R2: 6490; R_2010_5025Metric
R3: 36; R_2010_5025Metric
R4: 5K; R_2010_5025Metric
R5, R6: 680; R_2010_5025Metric
U1: LAUNCHXL-F28379D; PARTREV 2.0
U2: TMCS1133C3A; TMCS1133C5AQDVGR

Connections:
5V: U1.J3_1 (+5V_J3)
+3.3V: C2.1, C11.1, J1.3, J2.1, U1.J1_1 (3.3V_J1), U2.8 (VOC), U2.9 (VS), U2.10 (VS)
/A: D1.3, J3.1
/B: D1.4, J3.2
/C: D1.5, J3.3
/Voh: C7.1, L1.2, U2.1 (IN+)
GND: C1.2, C2.2, C3.2, C4.2, C5.2, C6.2, C7.2, C8.2, C9.2, C10.2, C11.2, D1.2 (-), J1.1, J2.2, J4.2, J6.1, R3.2, R5.2, U1.J2_10 (GND_J2), U1.J3_2 (GND_J3), U1.J6_10 (GND_J6), U1.J7_2 (GND_J7), U2.3 (GND), U2.4 (ALERT), U2.7 (OC)
Io_S: C6.1, U1.J7_5 (ADCINB5/ANALOGIN), U2.6 (VOUT)
unnamed: J5.1, J5.2, L1.1
unnamed: R2.2, R3.1
unnamed: R5.1, R6.2
PWMA: C1.1, J1.2, U1.J4_10 (GPIO0/PWMOUT1A)
VHV: C3.1, C8.1, C9.1, C10.1, D1.1 (+), J4.1, R1.1
VHV_S: C4.1, R1.2, R2.1, U1.J3_8 (ADCINB2/ANALOGIN)
Vo: J6.2, R4.1, U2.2 (IN-)
Vo_S: C5.1, R4.2, R6.1, U1.J7_4 (ADCINC5/ANALOGIN)

Notes on the sheet:
Aux power connection
Signal connections to gate driver EVAL board
Out Connection from gate driver EVAL board
Generator connecton
*MOSFET and diode are located on the external gate driver evaluation board
HV and GND Connection to gate driver EVAL board
Battery pack connection

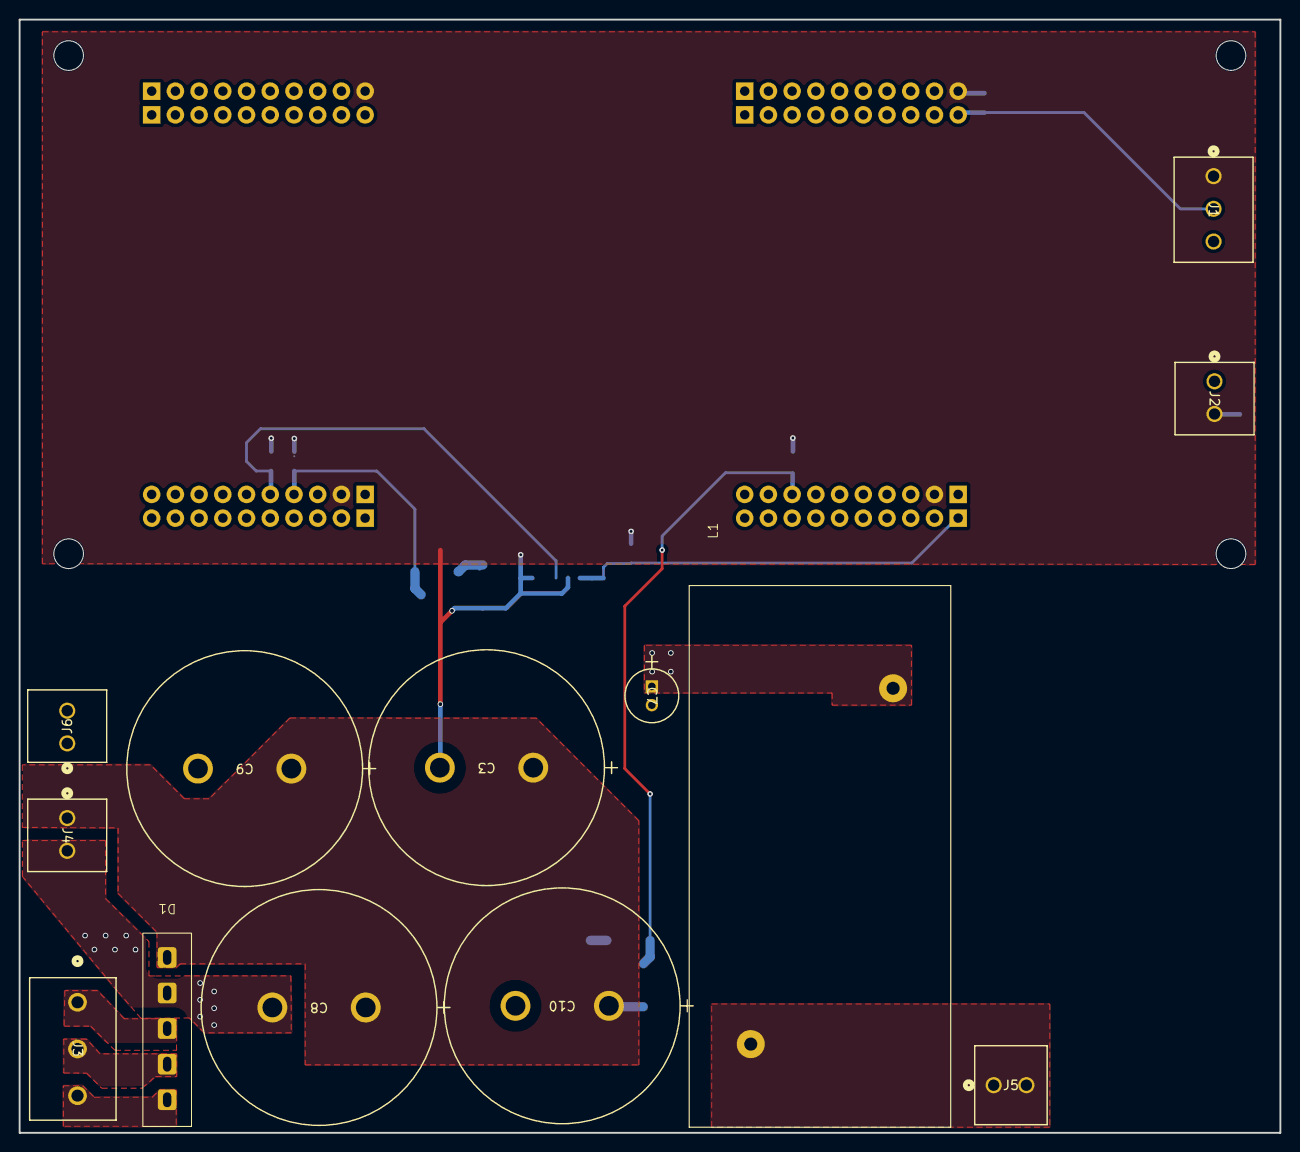
[picture p36: board Build.kicad_pcb from above]

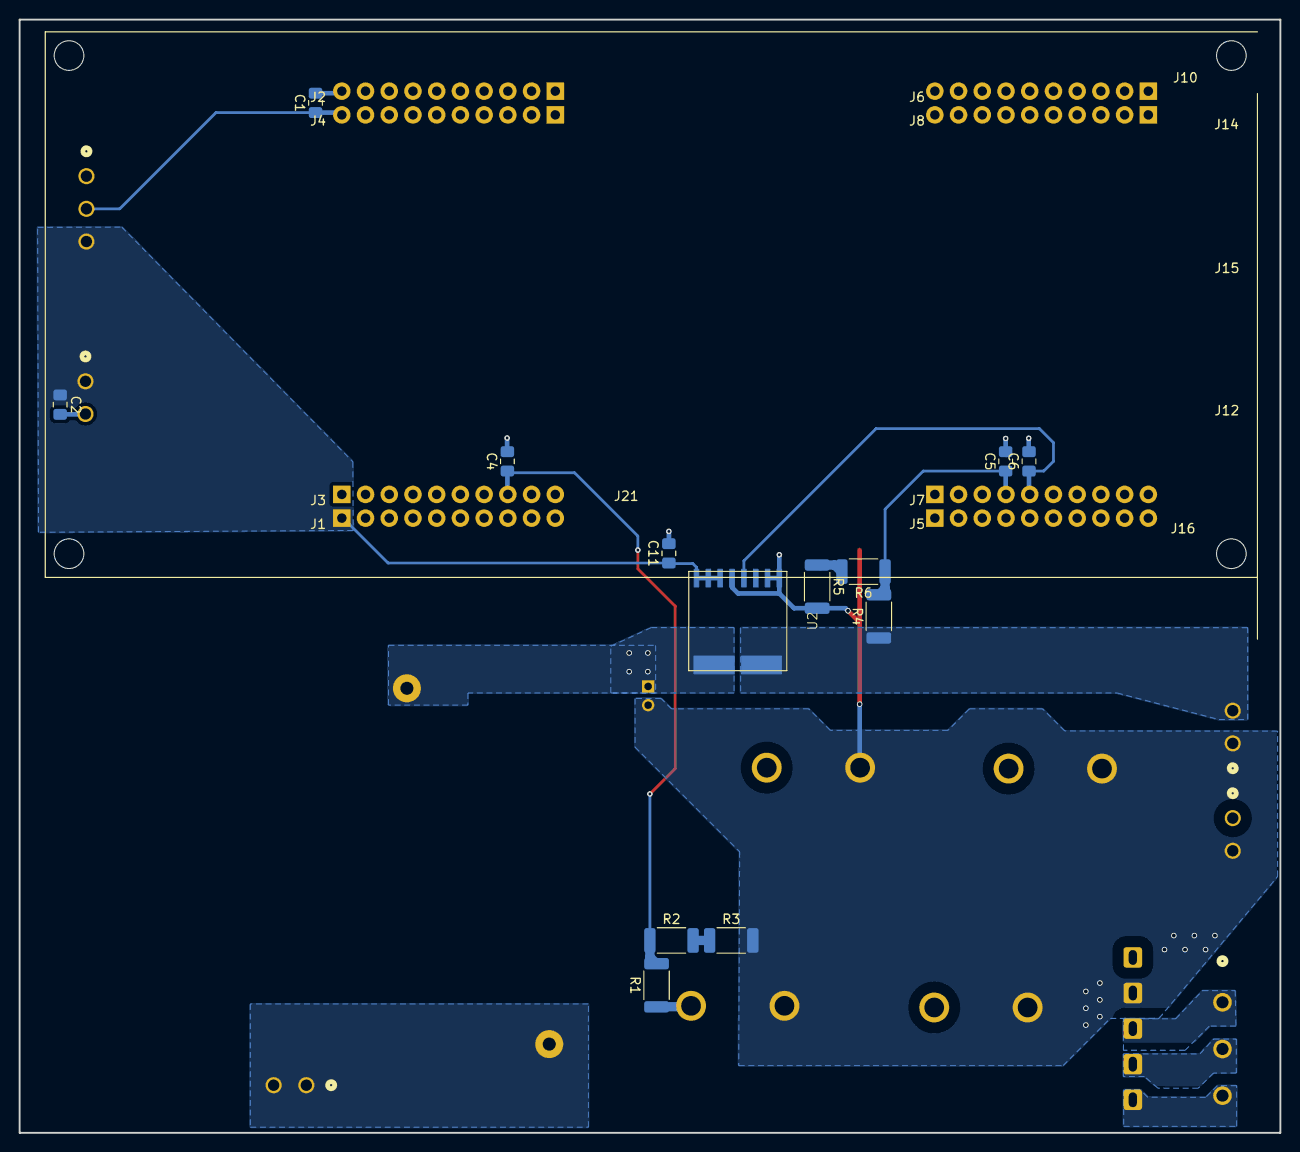
[picture p37: board Build.kicad_pcb from below]

Board: 2 copper layers, 135.0 x 119.2 mm, 27 parts (14 on the bottom side), 15 nets.
