23vsgroi/Battery-Charger/Battery Charger Project/KiCad/Prototype/TEST1_v2/TEST1_v2/TEST1_v2.kicad_pcb

## KiCad design Battery Charger Project/KiCad/Prototype/TEST1_v2/TEST1_v2/TEST1_v2.kicad_pcb (2026-10-10)

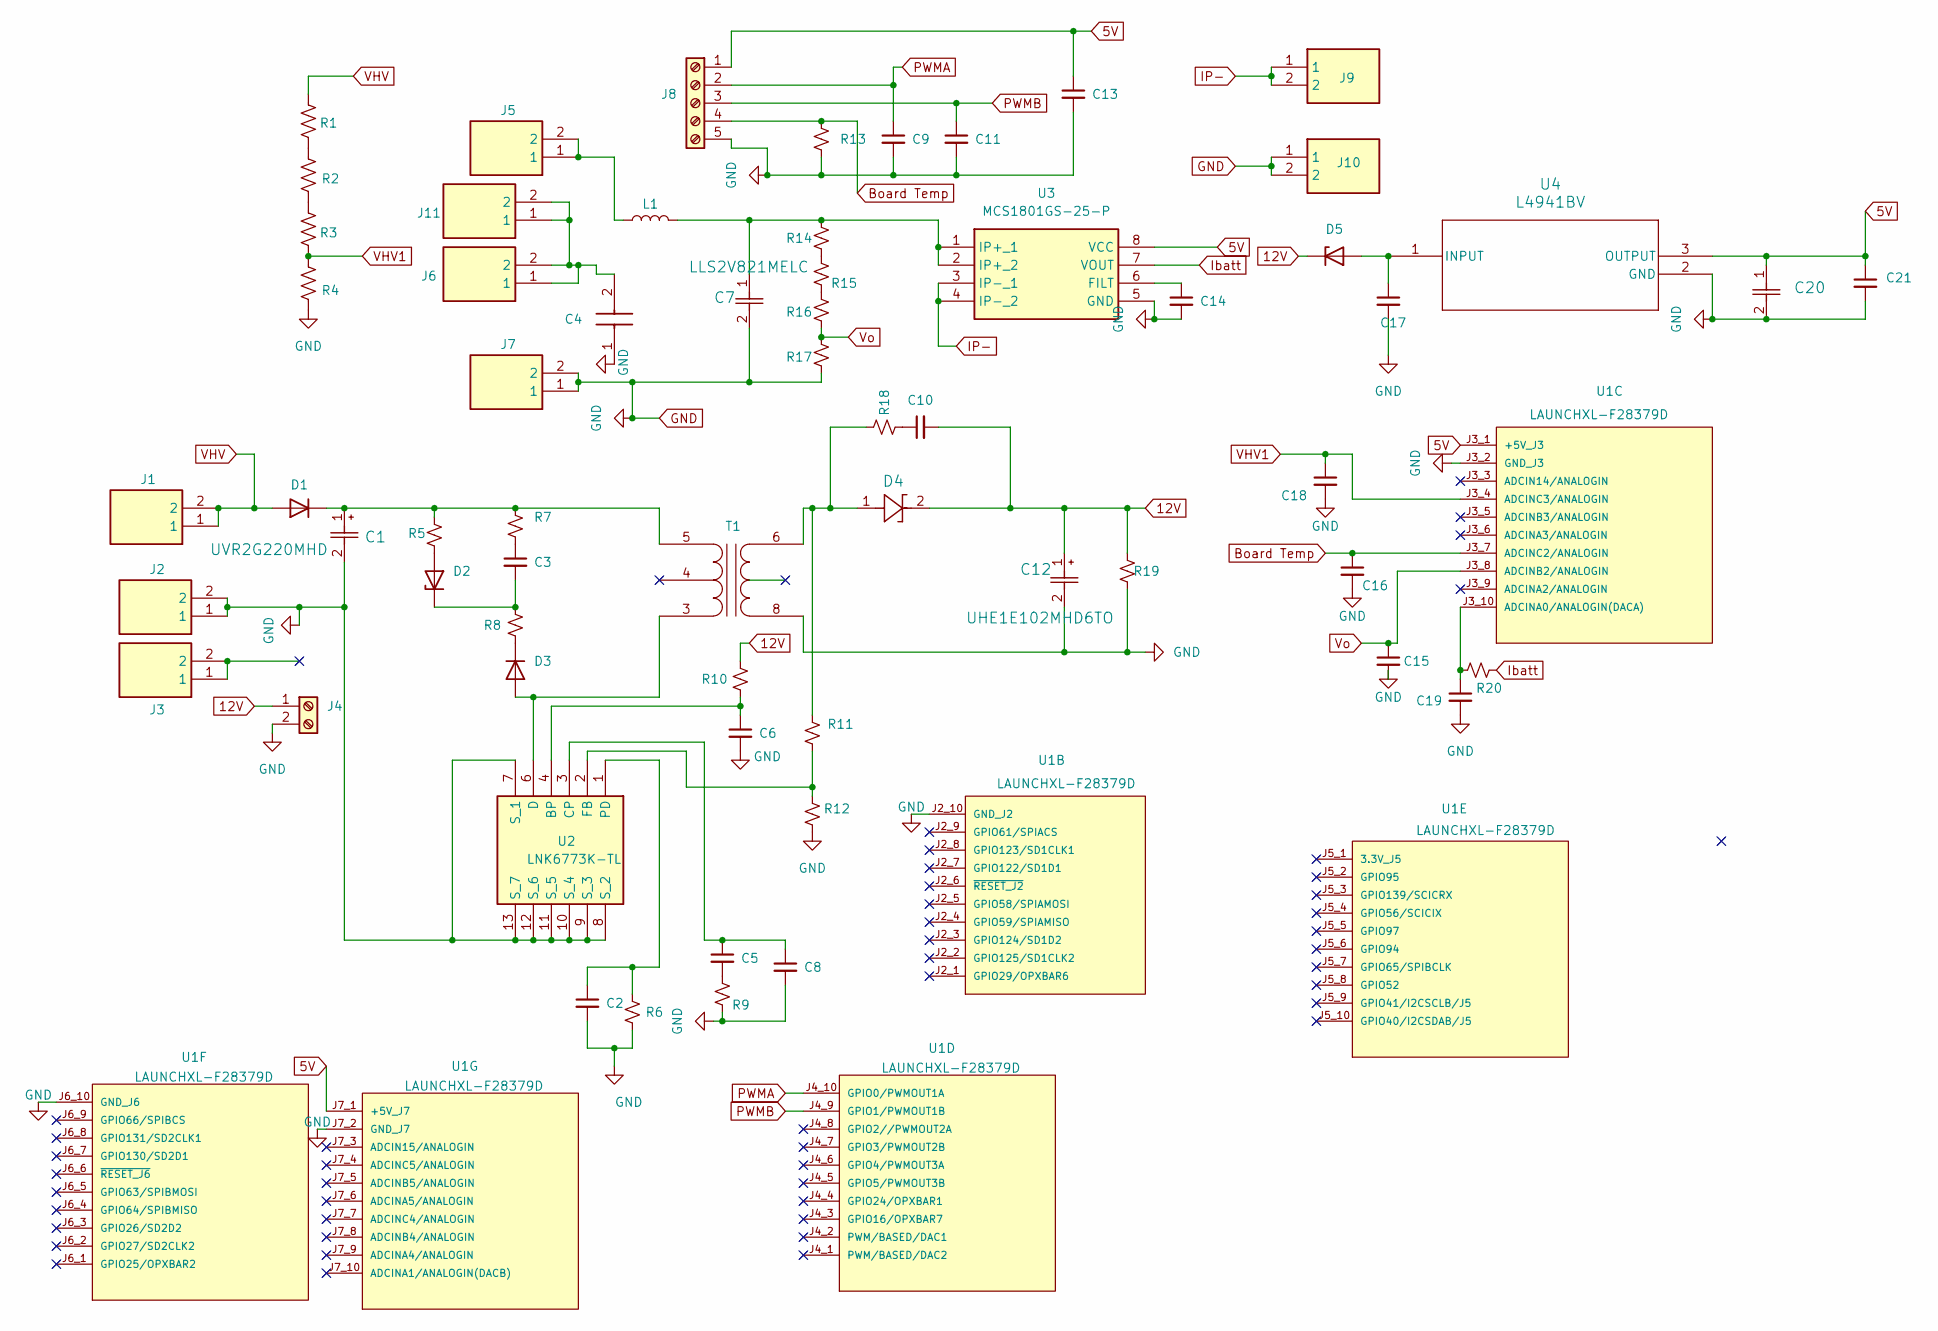
[picture p38: schematic TEST1_v2.kicad_sch]

Parts:
C1: UVR2G220MHD; CAP_UAQ_16X25_NCH
C2, C3, C10: C_Small; C_1206_3216Metric
C4: B32673P6225K000; B32673P__26.5_x_12_; Manufacturer_Part_Number B32673P6225K000; Mouser Part Number 871-B32673P6225K000
C5, C6, C8, C9, C11, C13, C14, C15, C16, C18, C19: C_Small; C_0805_2012Metric_Pad1.18x1.45mm_HandSolder
C7: LLS2V821MELC; CAP_C45_NCH
C12: UHE1E102MHD6TO; CAP_UAQ_12P5X20_NCH
C17, C21: 0.1uF; C_0805_2012Metric_Pad1.18x1.45mm_HandSolder
C20: CAP_WCAP-ATG5_05.0X11.0_WRE
D1, D3: US1M; D_SMA
D2, D5: D_Zener; D_SMA-SMB_Universal_Handsoldering
D4: STPS2H100U; SMB_STM
J1, J2, J3, J5, J6, J7, J9, J10, J11: 726386-2; Mouser Part Number 571-726386-2
J4: Screw_Terminal_01x02; TerminalBlock_bornier-2_P5.08mm
J8: Screw_Terminal_01x05; TerminalBlock_Phoenix_MPT-0,5-5-2.54_1x05_P2.54mm_Horizontal
L1: L; inductor_customized_v1
R1, R2, R3, R4: R_US; R_2010_5025Metric
R5, R7, R18, R20: R_Small_US; R_1206_3216Metric
R6, R9, R10, R14, R15, R16, R17: R_Small_US; R_2010_5025Metric
R8: R_Small_US; R_1206_3216Metric_Pad1.30x1.75mm_HandSolder
R11, R12, R19: R_Small_US; R_0805_2012Metric
R13: R_Small_US; R_0805_2012Metric_Pad1.20x1.40mm_HandSolder
T1: Transformer_SP_1S; Transformer_cust_v1
U1: LAUNCHXL-F28379D; MOD_LAUNCHXL-F28379D_v2; PARTREV 2.0
U2: LNK6773K-TL; LNK6773KTL; Mouser Part Number 869-LNK6773K-TL
U3: MCS1801GS-25-P; SOIC127P600X175-8N; Manufacturer_Part_Number MCS1801GS-25-P
U4: L4941BV; TO-220_STM

Connections:
5V: C13.1, C20.1, C21.1, J8.1, U1.J3_1 (+5V_J3), U1.J7_1 (+5V_J7), U3.8 (VCC), U4.3 (OUTPUT)
12V: C10.2, C12.1, D4.2, D5.1 (K), J4.1, R10.1, R19.1
Board Temp: C16.1, J8.4, R13.1, U1.J3_7 (ADCINC2/ANALOGIN)
GND: C1.2, C2.2, C4.1, C6.2, C7.2, C8.2, C9.2, C11.2, C12.2, C13.2, C14.2, C15.2, C16.2, C17.2, C18.2, C19.2, C20.2, C21.2, J2.1, J2.2, J4.2, J7.1, J7.2, J8.5, J10.1, J10.2, R4.2, R6.2, R9.2, R12.2, R13.2, R17.2, R19.2, T1.8 (S1), U1.J2_10 (GND_J2), U1.J3_2 (GND_J3), U1.J6_10 (GND_J6), U1.J7_2 (GND_J7), U2.7 (S_1), U2.8 (S_2), U2.9 (S_3), U2.10 (S_4), U2.11 (S_5), U2.12 (S_6), U2.13 (S_7), U3.5 (GND), U4.2 (GND)
IP-: J9.1, J9.2, U3.3 (IP-_1), U3.4 (IP-_2)
Ibatt: R20.2, U3.7 (VOUT)
unnamed: C3.1, R7.2
unnamed: C4.2, J6.1, J6.2, J11.1, J11.2
unnamed: C5.2, R9.1
unnamed: C10.1, R18.2
unnamed: C1.1, D1.1 (K), R5.1, R7.1, T1.5 (PR1)
unnamed: D2.2 (A), R5.2
unnamed: C3.2, D2.1 (K), R8.1
unnamed: D3.2 (A), T1.3 (PR2), U2.6 (D)
unnamed: D3.1 (K), R8.2
unnamed: C17.1, D5.2 (A), U4.1 (INPUT)
unnamed: J5.1, J5.2, L1.1
unnamed: R1.2, R2.1
unnamed: R2.2, R3.1
unnamed: R14.2, R15.1
unnamed: R15.2, R16.1
unnamed: D4.1, R11.1, R18.1, T1.6 (S2)
unnamed: C19.1, R20.1, U1.J3_10 (ADCINA0/ANALOGIN(DACA))
unnamed: C6.1, R10.2, U2.4 (BP)
unnamed: C5.1, C8.1, U2.3 (CP)
unnamed: R11.2, R12.1, U2.2 (FB)
unnamed: C2.1, R6.1, U2.1 (PD)
unnamed: C14.1, U3.6 (FILT)
unnamed: C7.1, L1.2, R14.1, U3.1 (IP+_1), U3.2 (IP+_2)
PWMA: C9.1, J8.2, U1.J4_10 (GPIO0/PWMOUT1A)
PWMB: C11.1, J8.3, U1.J4_9 (GPIO1/PWMOUT1B)
VHV: D1.2 (A), J1.1, J1.2, R1.1
VHV1: C18.1, R3.2, R4.1, U1.J3_4 (ADCINC3/ANALOGIN)
Vo: C15.1, R16.2, R17.1, U1.J3_8 (ADCINB2/ANALOGIN)

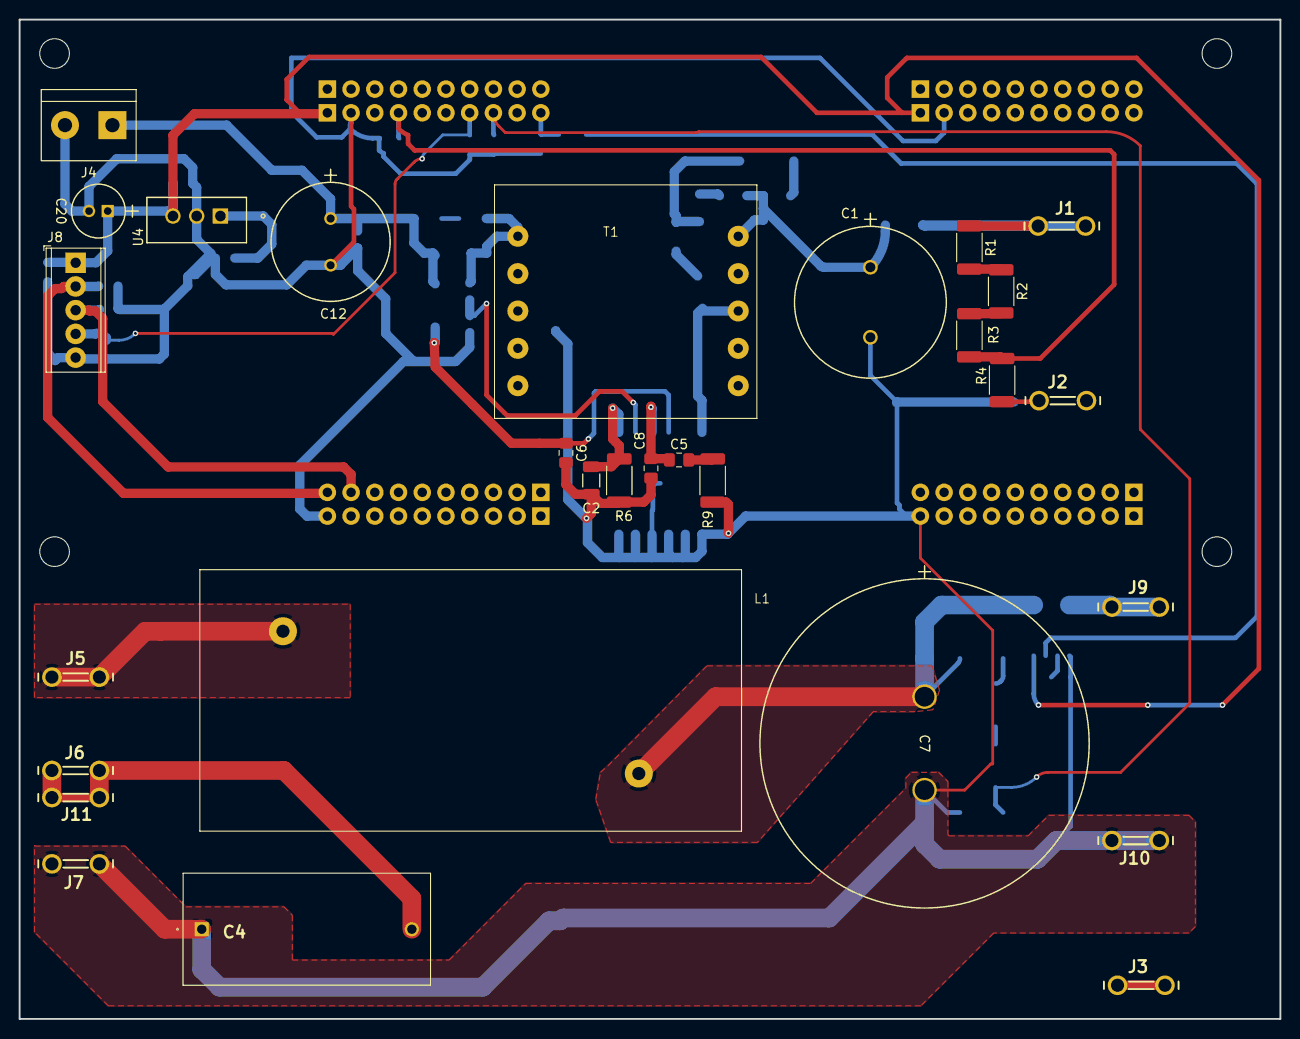
[picture p39: board TEST1_v2.kicad_pcb from above]

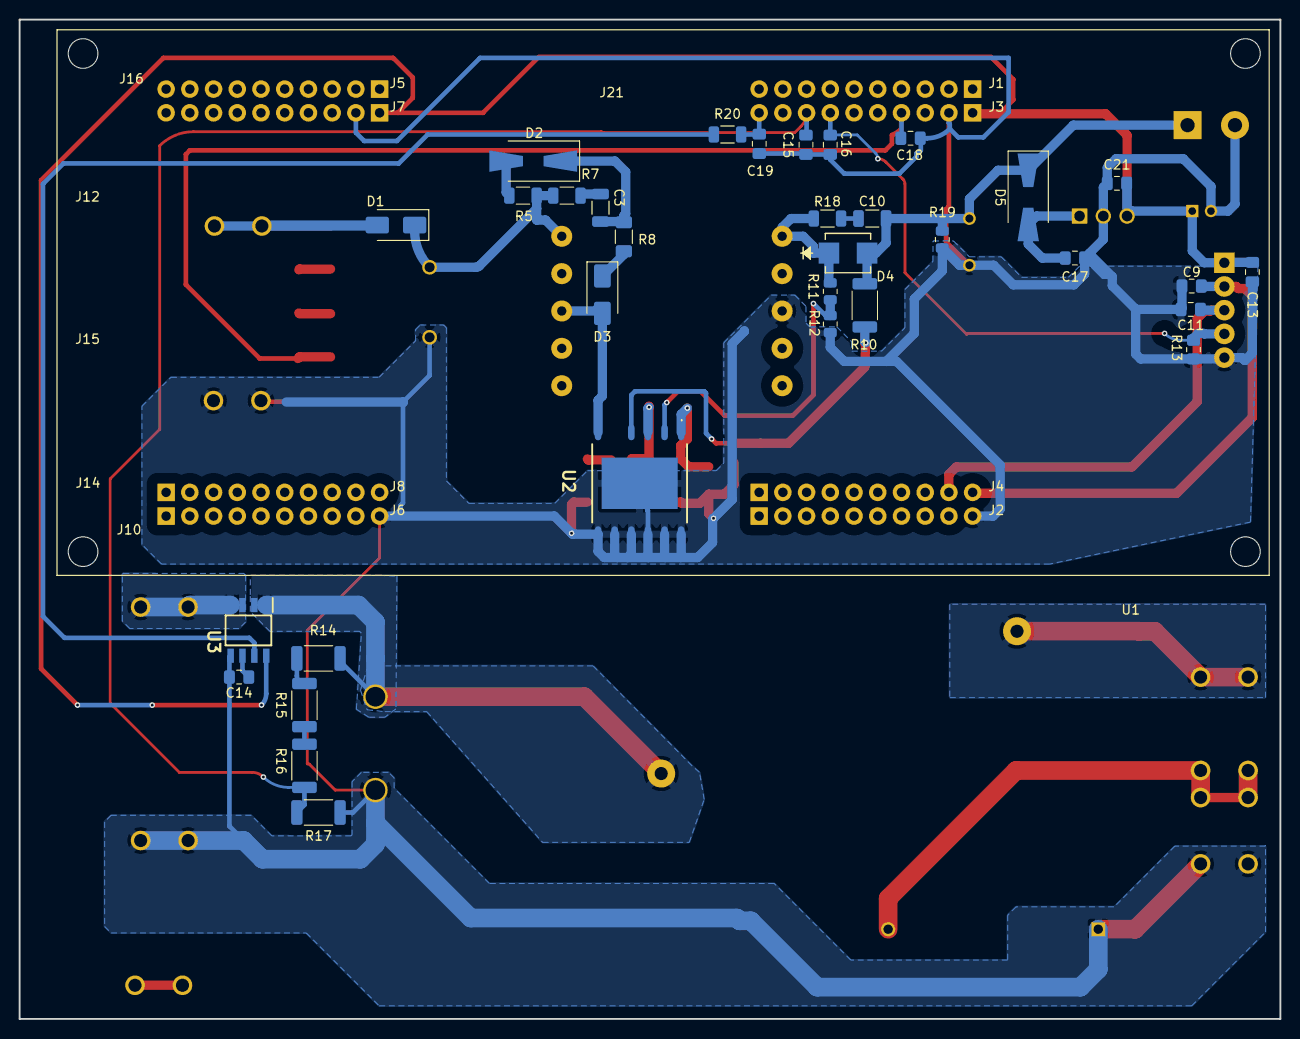
[picture p40: board TEST1_v2.kicad_pcb from below]

Board: 2 copper layers, 135.0 x 107.0 mm, 63 parts (34 on the bottom side), 34 nets.
