23vsgroi/Battery-Charger/(commit log)

2026-07-07 deleting file versions
    Making it so I do version control in git instead of manually copying files like V1, V2 ...
    [Component calcs V1.xlsx, Component calcs.xlsx]
2026-07-07 component calc V1
    The excel sheet Component calcs in this commit contains the first version of the excel sheet that was used to get the first BOM, which is also in this commit.
    [Component calcs.xlsx]
2026-07-07 removed comp calc V1 from excel sheet
    [Component calcs.xlsx]
2026-07-07 Added annotation
    Added annotation to wind charger buck file. The file contains the first simulation based on the initial calculations
2026-07-08 MATLAB code up dates
    I updated the worst case analysis MATLAB code to include a loop that removes operating points outside of the duty cycle range.
2026-07-10 Excel,Matlab,Plecs additons
    I made the plecs simulation so that the two circuits would show the absolute worst current or voltage ripple. I worked to intigrate 12V and 24V analysis together by using excel to find that absolute worst cap and indu value if only one was used in all cases. updated Matlab simulation to have 12V and implemented a graph.
    [Component calcs.xlsx]
2026-07-14 updates to calcs
    [Component calcs.xlsx]
2026-07-17 Choose rec capacitor
    I used my matlab simulation graph to choose a capacitance value that was reasonable. It ended up being 0.084 with a 0.01 voltage ripple when the VLL was 48V (12V batt) or 60V (24V batt). I also made simulations in plecs that show the worst rec capacitor ripple, worst buck output cap ripple, worst current ripple, and random operating points. Both in and out cap ripple voltage ripples should be below 1%. Current ripple should be below 30%.
    [Component calcs.xlsx]
2026-07-21 small changes
    [Component calcs.xlsx]
2026-07-29 Added research papers and PLECS batt model
    I found an amazing plecs simulation that is made specifically for simulating LI-ion batts. I also added the research paper it is based on. Additionally, I found a research paper that contains a ton of information and graphs about the LFP battery we are using.
2026-07-31 Updated Li-ion EQ circuit
    I updated the LFP battery equivalent circuit with one I found in a premade plecs diagram. I updated it with data from out battery I found in a paper using search tables.
2026-08-04 Experimented with battery
    Tried to gain an understanding about how charging current is established and how far over VOC the charging voltage would need to be. I did this by choosing a charging current and multiplying it by internal resistance to find the amount of charging voltage above VOC.
2026-08-07 Tested LFP model
    I tested the LFP battery model to try to figure out what the voltage above VOC would need to be to charge at 24A (3C). Unfortunately, I found that the voltage would be about 6.1V large at most, which means a charging voltage of about 4.2V for each individual cell. This means there is an issue with the model because the LFP data sheet says to switch to CV mode at 3.65V, which would be less than half charged with the current model.
2026-08-17 Plecs sim update
    My last push had the charging simulation which did not work. I updated the sim to work and match the graph from the last push
    [Component calcs.xlsx, Schedule.xlsx]
2026-08-17 Plecs simulation updats
    Dr. McIntyre told me that two RC branches are not necessary for charging curve. Therefore, I removed the RC branches from the model. I also updated the VOC-SOC lookup table to more accurately reflect the research paper. I added graphs of the new simulation results.
2026-08-18 Mid session update
    Next push at the end of the session will contain the details
    [Component calcs.xlsx]
2026-08-18 Batt model
    I decided to move forward with the one resistor batt model for the first prototype. I updated this in the battery test plecs model. I added a discharge simulation. I added a graphs folder for discharge and charging. I implemented CV mode in the battery test plecs simulation so I could accuarately choose values for the calculations.
    [Component calcs.xlsx]
2026-08-20 VOC(SOC) updates
    I updated the LFP battery in the simulation to have a max VOC of 3.65 and min of 2.5 to better match the data sheet and experimental results. I have also updated the charge and discharge graphs to show this change.
2026-08-21 Updated sim and clacs
    I changed the charging current from 3C (24A) to 1C (8A). I updated the simulation graphs and calculations.
    [Component calcs.xlsx]
2026-08-24 Many updates
    -Updated battery model min and max OCV
    -Updated the 12V and 24V calc excel sheet to reflect the new battery model parameters
    -I updated the MATLAB simulation to find the peak inductor values and capacitor values for both 12 and 24. Next I
    Next, I need to choose a Filter capacitor and find the peak buck capacitor.
    [Component calcs.xlsx]
2026-08-25 Safety push
    [Component calcs.xlsx]
2026-08-25 MATLAB code additions
    I made the MATLAB code able to graph C vs VLL for a range of charging currents.
    [Component calcs.xlsx]
2026-08-26 safe push
    [Component calcs.xlsx]
2026-08-27 Many updates
    -Added PWM Feedback to PLECS simulation!
    -Changed rectifier voltage ripple to 5% to allow for a smaller capaciter value
    -Added buck capacitor and inductor values to the matlab sim
    -Decided to design for a range of charging currents
    -The plan is to change charging current depending on the generator output.
    [Component calcs.xlsx]
2026-08-31 updates
    I tested the simulation with the values I chose and at some operation points I was getting large oscillations in output current. Turns out the PI controller I coded was doing it because of inaccuracy, so I changed it to a different system that just divides the voltage needed at the output by the input voltage to get the duty cycle. The error is now much lower and the simulation works great. I also started a BOM, but it is difficult to find an inductor, and the rectifier I was planning to use is out of stock :(
    [BOM V2.xlsx, Component calcs.xlsx]
2026-08-31 updates
    Realized that my inductor value was very oversize because I was designing as if 2A charging current would be used all the way up to 155V p-p out of the generator when in reality it would switch to 8A charging around 60V
    [BOM V2.xlsx, Component calcs.xlsx]
2026-09-02 updates
    Changed it so the inductor value accurately represents the current ranges. I updated this in the PLECS simulations and am now working on the BOM
    [BOM V2.xlsx, Component calcs.xlsx]
2026-09-08 started on schematic
    [BOM V2.xlsx, Build.kicad_pcb, Build.kicad_sch, Component calcs.xlsx, TEST1_v2.kicad_pcb, TEST1_v2.kicad_sch, Wind charger.kicad_sch]
2026-09-10 Made more progress on schematic
    Changed current sense IC.
    [Build.kicad_sch]
2026-09-10 Added demo folder
    [Build.kicad_sch, Wind charger.kicad_sch]
2026-09-11 ISSUE FOUND
    I found that the reason that the voltage ripple is very low is because I have a battery as a load, and the equation I used does not account for this. Essentially the ac component of the current sees the battery impedance as lower than the capacitors.
2026-09-15 New solution
    I discussed with Dr. McIntyre and he told me to lower the filter capacitor value and allow for more current ripple.
    [BOM V2.xlsx]
2026-09-18 Lowered cap and started BOM
    I lowered the filter cap to 2.2mF and started the BOM. I found a rectifier, rectifier capacitor, and diode. All that is left is the buck capacitor, MOSFET, and PCB stuff,
    [BOM V2.xlsx]
2026-09-22 BOM FINISHED
    BOM has been fully completed and I will now start the PCB layout
    [BOM V2.xlsx]
2026-09-22 Schematic updates
    I sized the voltage divider resistors and began assigning footprints. I switched the generator connector for a new one that had a footprint in ultra librarian. It can also handle a higher current and voltage.
    [BOM V2.xlsx, Build.kicad_pcb, Build.kicad_sch]
2026-09-28 Dr.Mcintyre suggestions
    Dr. McIntyre suggested using much larger resistors (100K+) for the voltage divider resistors. He also asked me to prepare a slideshow for the company with the KiCad schematic, Plecs sim, etc.
    [BOM V2 UNIT.xlsx, BOM V2.xlsx, Component calcs.xlsx]
2026-09-29 Made presentation and added footprintst
    I finished the presentation. This required me to remove some things from the simulation to make it more understandable. I also just about finished adding all the footprints for the PCB
    [BOM V2 UNIT.xlsx, Build.kicad_pcb, Build.kicad_sch, Gen data.xlsx, Wind charger.kicad_sch]
2026-10-10 More updates on PCB design
    I forgot to push my changes for the last week, but I layed out the components and began routing traces and copper pours.
2026-10-12 PCB updates
    Dr. Mcintyre suggested using large pours for the high voltage and gnd planes. He also asked me to implement design constraints. The main concern is the distance between the high DC bus and gnd near the rectifier.
2026-10-13 PCB updates
    Added pours and net class clearances
2026-10-14 PCB updates
    Added larger planes and a top ground pour connected to the rec to help with the bottleneck. Also put some vias to distribute current and heat
2026-10-16 PCB updates
2026-10-20 PCB about done
2026-10-20 PCB complete
2026-10-22 PCB ORDERED
    This push contains the PCB version and Gerber files that were ordered for the first prototype.
2026-10-27 Began C control code
    I started programing the control code in C. I have been using bare metal with no header files or drivers from TI. Dr. McInyre wants me to use plecs so I will probably do that aswell. PCB parts and components came in today.
